minto0218/autotransfer/handoff_2026-11-08/READ_FIRST_SOURCE.md

# 軽量版の引き継ぎ

最初にREADME.md、HANDOFF.mdを読んでください。
このZIPにはCAD原本・仕様・環境構築ファイル・過去の検証記録・参照用依存ファイルが入っています。
生成済みHTML、STEP、STL、3MF、画像などの大きな成果物は省略しています（旧版比較用の依存STL等を除く）。
過去の検証記録は今回の再実行結果ではありません。
新しい環境でSETUP.mdに従い依存ライブラリを導入し、CADを再生成してください。再生成は未検証です。
省略した成果物を含め元ZIPを完全復元する場合は、同梱の分割ファイルを全て集めて結合します。
この軽量版は単独で設計の引き継ぎを始めるためのものなので、分割ファイルは必須ではありません。
