minto0218/autotransfer/handoff_2026-11-08/v0_12/docs/ばねの点検と交換.md

# V0.12 ばねの点検と交換

金属引張ばねを戻し力に使うことは一般的な機械の構成です。[Lee Springの用途説明](https://www.leespring.com/learn-about-extension-springs)も戻し力の用途を挙げています。ただし、今回のJB-14をこの運動で使った寿命試験は行っていません。

## 今の設計でできていること

- 各ヘッドの一枚側板に水平ばね3本。側板はケースへM2×2で着脱でき、ばね単体も固定ねじと糸の結びを外して交換可能。
- ねじりに合わせてばねが回転することはありません。側板は固定ケース側で、引き抜くときはヘッドと一緒に移動します。
- 自由長14mm。公称予伸び2mm、運転全域の最大伸びは把持16.19／ねじり6.19／押込み9.54mm。カタログ許容たわみ20.4mm以内という計算です。許容範囲内であることは長期寿命の保証ではありません。
- 予圧は戻し糸の有効長を調整します。固定ねじ自体に送りねじ式の予圧調整機能はありません。ばねを傷めるねじ込みや、コイルを引っ掛ける調整はしません。

## 寿命について

ばねには疲労寿命があり、負荷の大きさと振幅、材料、フック形状、腐食、傷などが影響します。特に引張ばねのフックには曲げとねじりが加わるため、コイルより先に問題が出る場合があります。[Century Springの設計説明](https://www.centuryspring.com/resources/how-to-select-an-extension-spring)。同ページにある同社製品の目安回数を、メーカーの異なるJB-14へそのまま当てはめることはできません。

張力低下を調整して補える場合はありますが、張力が正常でも亀裂などの疲労を完全に検出できるとは限りません。予圧を増やし続けて使う運用にはせず、実際の繰返し試験から交換回数と点検間隔を決めます。今の段階で具体的な保証回数は設定しません。

## 小さなヘッドのまま点検する案

ヘッドに荷重センサーを常設する代わりに、外部の点検治具に一個のフォースゲージ／ロードセルを置き、各系統を順に測る方法を推奨案とします。これは将来の追加案で、CADにはセンサーや自動点検治具をまだ実装していません。MG90Dの角度指令だけから張力は測定できません。

最初の手動点検手順：

1. 無負荷で糸の摩耗、フックの変形、コイルの接触、案内輪の回転を確認。ばねを外し、永久伸びがないか自由長も比較。
2. 同じ温度・同じ二つのばね長で、引く方向と戻す方向の力を別々に測り、新品基準と比較。ばね単体を測るとばね特性、糸を通して測ると案内摩擦を含む特性になるので、両者を混同しない。
3. 二点間の力の差からばね定数の変化、往復の差から摩擦の増大、同じ位置での力のずれから予圧・永久伸びの変化を調べる。初張力のカタログ値は未記載なので、最初の実測値を基準にする。
4. 異常のない糸長の軽微な変化なら結び直して予圧を調整。運転端で伸びの上限を越えないことを確認。ひび、フック変形、永久伸び、繰返す力の低下があれば交換。
5. 調整後に開口35〜5mm、連動ねじり±30°、押込み20mm、復帰とロック位置を確認する。

自動化では「運転回数を記録→点検治具へ移動→基準位置で低速計測→基準との差と往復差を判定→調整または交換要求」という手順にできます。サーボの原点補正は主糸側の位置ずれには使えますが、同じ開口でのばね予圧を変えるには糸長または固定点の調整が必要です。交換判断の閾値・点検間隔は実測後に設定します。センサーを付けない自動プログラムは、回数の記録と点検の案内までです。

この版ではモーターへの送信、保守プログラムの実機実行、自動張力測定はしていません。
