minto0218/autotransfer/handoff_2026-11-08/SPEC.md

# 現行仕様と今後の設計条件

単位mm・角度deg。2026-11-08。参考PDFの図は設計資料であり、後のユーザー要求で置き換えた条件より優先しない。

## 全体装置の要求

- 新旧2バイアルの栓を把持→ねじり→斜め引抜き→同じ側へ退避→逆順復帰→押込み→解放。
- バイアル径約23、高さ約96、栓長約30、想定最大外径30、装着時の突出約10。
- 接触する爪は底面基準Z100〜105、爪高さ約5。最大開口35、最小約5。実際にスポンジを5まで圧縮する意味ではない。
- ヘッド中心間52（V0.12）。回転部のCAD包絡半径25、ヘッド間余裕2。一周の包絡表示は360°実機駆動の意味ではない。
- 上下の同軸中空2ドラム、把持と中心軸周りのねじりを連動制御。旧仕様の爪前後逆移動ねじりは現在方式ではない。
- 押し足は全体の初期位置Z127→107、20mmストロークと棒回転120°。初期要求の最大30mm以内。
- 上側固定フレームへサーボ集約。全体保存版は7サーボ案（把持2、ねじり共通1、引抜き2、押込み2）。元の5個に固定しない。
- 2関節を共通軸と両側支持で構成。柱を退避側支点へ近づけ、両バイアルは同じ側へ抜く。
- ヘッドはバイアルごとに構造的独立、ねじで連結可能。バイアル供給側の外半周ホルダーを撤去し、内側に受けを置く。
- 機械式ストッパー・固定ピンで電源OFF時の基準姿勢を固定。サーボ保持だけに頼らない。
- 本番は金属。現試作はPLAで機構・組立確認。耐久最適化より、組み上がり・可動性・小型化を重視。

## 卓上B3で実装している範囲

独立ヘッド1個、支持台、手引きつまみG/T/P、ばね戻し。バイアル、全体アーム、サーボ、Pico、長い外部ボーデンは使わない。

- 開口35→5、爪高さ5、中空2ドラム。
- ねじり0〜＋30°、両端ストッパー。Tばねは0°でも約2mm伸ばし、0°で自由長14→設置長16。
- 固定ばね側板1枚に水平引張ばね3本。自由案内輪3個、共通軸M1.6×16。
- G/T連動が必要。＋30°でT糸約6.81mm引き、開口維持のG糸を約5.37mm戻す。全主糸を解放するだけの全軸原点復帰ではない。
- 押込み20＋回転120。カムは左右分割、棒の上ドラムは別体。二面幅で棒へ回転を伝え、軸方向に滑らせる。
- ケース／カムの位置合わせキー、爪の上下・背面案内、ねじ止めレール端止め、押し棒上端固定ピン。
- 糸端ビーズはドラム内固定用。ヘッド交換用ケーブルコネクタではない。

## 未採用／未設計の別案

- 無操作時「爪閉約5・ねじり0・押し棒上」。内蔵回転ばねによる常時閉じ、引きで開く方式。
- ばねをなくす拮抗2本駆動。
- 3系統着脱ケーブル接続板、張力調整、モーター側クラッチによる停電復帰。
- 自動の原点・栓検出・張力測定、メンテナンスプログラム。
- ナイロック加工ねじの採用、金属製部品の板厚・軸受選定。

これらは会話上の候補で、既存CAD・印刷部品へ反映済みとしない。

## 合格判定を今後決める項目

必要把持力／ねじりトルク／引抜き力／押込み力、許容スポンジ変形、許容位置ずれ、目標サイクル時間、連続稼働回数、ばね・糸の交換間隔。数値が未指定のため推測で合格扱いしない。
