minto0218/autotransfer/handoff_2026-11-08/HANDOFF.md

# 引き継ぎ：ここから再開する

## 最初に理解すること

目的はショウジョウバエ飼育バイアルの栓を、新旧2本同時に把持・ねじり・引き抜き・退避・復帰・押込みする自動TF装置。モーターは上側固定フレームへ集約し、ヘッドには置かない。

**現在の製作対象は `bench_manual_v3`（B3）の独立ヘッド1個の卓上手動治具。全体装置の最新保存版は `v0_12`。二つを混同しない。** B3を全体へ統合済みとは扱わない。

ユーザーは部品を「全部買った」と申告済み。ただし全商品の型番・実測寸法・到着状況は未確定。印刷成功・組立成功・動作成功を報告した記録はない。未実施と未報告を混同せず、現物の状況を確認してから先へ進む。

## 保存済みの現物確認用データ

- B3：STL34種類47個（比較用フォロワピンを含む）、ねじ25本・ナット5個、JB-14ばね3本。
- 3MFの00＝嵌合確認、01＝ヘッド一式、02＝支持台。完成に使うのは01＋02、00は試し刷り。必要個数は配置済み。
- 3MFは形状・配置・方向のみ。Bambu Studioのプリンター／支持設定やG-codeは含まない。
- A1、普通のPLA。01は0.2mmノズル・積層0.06〜0.08mm推奨、02は0.4mm・0.12〜0.16mm可。
- 02は土台を下にした配置。上部取付横板の張出し下面にサポートが必要。「ビルドプレート上のみ」を出発点に、層プレビューで確認。ねじ穴に支持を詰めない。
- cable_stop_buttonは外径2.1、厚さ0.6、穴径0.8mm、3個。小さいのは意図どおりだが印刷成功未確認。
- フォロワは金属Ø1×5.8mmを推奨。軸・ねじの形状は参考で、印刷穴を仕上げる。金属ねじを購入して使用。

## 最近の会話の合意と未実装案

1. 当面は「主糸1本＋引張ばね戻し」。拮抗2本駆動は候補であり未採用。1ヘッド3主糸、拮抗化ならモーターまで6系統になる。
2. B3は糸を全部放すだけで全軸が原点へ戻る機構ではない。G/Tの連動が必要。
3. ヘッド交換には長いケーブルとヘッド内糸を分離できる端末を検討。タイコ／溝付き受け、外筒端面固定、張力調整が候補。3系統を一枚の蓋で保持する案は独自の未設計案。現在のB3に着脱接続部はない。
4. 最後に相談した別案：無操作時に開口約5mm・ねじり0°・押し棒上端へ戻る「ばね閉じ」構造。把持／ねじり／押込みドラムの内部にねじりばねを置く案。**説明しただけでCAD未変更・性能未検証。** 初期仕様「ばねを主たる把持力保持にしない」とは異なるため、採用の最終合意と条件整理が必要。
5. サーボが停止しても保持していれば戻らない。「糸を送り出す」「電源OFF」「クラッチで解放」を別に扱う。電源OFF自動復帰は未設計。
6. 緩み止めは本番でナイロック加工ねじ等を候補。横力は位置決め部で受ける設計を優先。HARDLOCKナットはM5以上の標準品が中心で今回の小ねじには非採用。金属用嫌気性ロック剤をPLAへ安易に使わない。

## 購入に関する引き継ぎ

- 個人購入を前提。大手優先、特にヨドバシを好む。同じ店なら注文・送料をまとめたい。
- モノタロウの小頭ねじで事業者限定制限が判明、AXELも個人注文不可。購入ページに掲載があるだけで個人購入可と断定しない。
- B3_購入リンク.mdは個人向けへ更新した記録。販売価格・在庫・納期は古くなるため再確認。
- S05ばね掛けM1.4×8は頭径2.4以上。楽天ウィルコの0番3種（径2.5・高さ0.8）を代替案内。組立用S04の頭径2.0と取り違えない。
- Amazon Zmbroll M2セット B0DMF4XHCZ：M2×8/16とナットの同梱は確認。ねじ頭径≤3.6、ナット対辺≤4.0／厚さ≤1.6の実寸未確認で、適合確定にしていない。購入したか不明。
- JB-14のビルディ掲載は納期未定・受注後メーカー発注・キャンセル不可。実際の出荷日不明。以前の「1〜2週間期待、製造待ち1〜3か月」は一般的推測でありメーカー回答ではない。納期の確定値として使わない。

## 検証の扱い

保存レポートには過去のCAD上の検査結果がある。B3保存結果：代表9姿勢、組立途中1499組、ねじり37姿勢、押込み41位置等。これは連続掃引・実物の摩擦・寿命・トルク・スポンジ適合の合格ではない。今回クラウドへ移して再検証したわけでもない。

現在不足するもの：実物の嵌合、ばね力と摩擦、G/T連動時の把持力、押込み反力の受け、ケーブル全行程の変形・張力、サーボ適合、TF180°回転の実動作、原点／異常検出、実機制御。

## 再開手順

1. README→SPEC→B3 HTML・組立手順を見る。
2. `python tools/project.py verify` でコピー整合性を確認。
3. SETUP.mdに従ってCadQuery環境を作り、smokeを実行。
4. ユーザーの実際の印刷・到着・組立状況を聞く。測定があれば保存データに優先して反映。
5. 変更前にB3/B4など版を分ける。B3原本とV0.12を上書きして未実装案を既成事実化しない。
6. 寸法変更→部品→組立→動作→印刷方向・個数→BOM→HTMLを整合させる。

## 次のAIに貼る文

このフォルダーは自動TF装置の引き継ぎ一式です。最初にHANDOFF.mdとSPEC.mdを読んでください。現行の印刷対象はbench_manual_v3のB3、全体保存版はv0_12です。最近のばね閉じ・内蔵ねじりばね・ケーブル着脱案は未実装です。保存済み検査を実機検証と混同せず、現在の印刷・組立状況から継続してください。環境はSETUP.mdとtools/project.pyを使ってください。
