minto0218/autotransfer/handoff_2026-11-08/v0_12/docs/配線と購入部品.md

# V0.12 ワイヤの経路と購入部品

## 試作用線材

今回は**PE編み糸約Ø0.3＋PTFE外径1.6／内径0.8**を試作基準へ変更した。PTFE外径1.59／内径0.8の実在例は[フロン工業F-8008-003](https://www.flon-ind.com/catalog/f-8008/)。これは摩擦を減らす試作用チューブで、補強入りボーデンと同等の圧縮剛性を保証しない。曲がりによるロスが大きければ補強アウターへ替える。チューブ端を受ける肩と交換フェルールをCADへ追加した。

細いステンレス7×7も比較候補だが、この版の表示線径は0.3。釣り糸の号数だけで径を決めず、通路へ実際に通して確認する。

## 主糸3本の通し方

ヘッド局所座標はバイアル中心がX0/Y0、初期ヘッド基準がZ116。取出口はG＝(+10.25,−18)、T＝(−13,−18)、P＝(−7.3,−15)。すべて上向き。

```text
上部巻取り輪
 ↓ インナー（引張り）
上部固定ソケット＋アダプタ ← アウター上端の反力を受ける
 ↓ 外部サービスループ：ヘッド用曲線長360、肘用240
ヘッド固定ケースのフェルール ← アウター下端の反力を受ける
 ↓ 裸線の縦穴
蓋付き90°案内＋短いPTFEライナー
 → ドラム接線 → 巻取り溝 → 内部エンドビーズ＋止め結び
```

主案内は固定の滑り案内。ベアリング式の小プーリーを増やしてはいない。蓋を外して糸とライナーを置けるため、閉じた細い曲がり穴へ無理に通す必要がない。摺動摩擦は現物試験で確認する。

局所配線色はG把持＝黄、Tねじり＝青、P押込み＝桃、戻し＝緑。HTMLの「ヘッドの配線・案内の蓋を外して見る」で経路を見る。「ドラム内のワイヤ固定」は内部座を見る。座標一覧は`output/ワイヤ経路.csv`、中心線原本は`validation/wire_centerlines.json`。

外部曲線長は旧側3本・新把持・新押込みが各360、新ねじりは各姿勢とも400、肘は各240mm。新ねじりは退避姿勢でケースを避けるため40mm延長した。これらはチューブ切断長そのものではない。ヘッド側立上り5.3と端末挿入各約3を加えると、試作用の概算は通常のヘッド用約371.3mm、新ねじり用約411.3mm。現物フェルールと調整分を含め、長めに仮組みしてから端面を揃える。インナーには巻付き・結び・調整代を追加する。先に短く切り過ぎない。

## 局所戻し糸とばね

市販の**東京発条JB-14**を各ヘッド3個、計6個使う。外径2.5、自由長14、線径0.23、k0.05N/mm、許容たわみ20.4、最大荷重1.13N。[TRUSCO掲載のメーカー規格表](https://trusco.meclib.jp/library/books/orangebook2025_2/book/pdf/1425.pdf)。表の40.5は巻数、0.095は質量で、初張力ではない。

ばねをドラム間へ直接入れる代わりに、交換しやすい側面カセットへ置く。各ドラムの小さな別溝→短い戻し糸→R4自由回転案内輪→水平ばねの可動フック、固定フック→横ねじ→共通側板→ケースという力の経路。案内輪は高さの異なる3個を一本のM1.6共通軸へ通す。ばねは局所X18、Y方向に伸縮し、高さはG14.65／T21.6／P25.1。固定フックはY18。ケース側なのでねじり時には回らず、引き抜きではヘッドと一緒に移動する。主駆動のボーデン本数は増やさず、ユニット内だけ戻し糸が3本増える。

- 把持戻し溝R4、下ドラム絶対角−173.24〜+30°を対象。ばねの初期伸び2に角度分を加え、最大伸び約16.19mm。
- ねじり戻し溝R4、−30〜+30°。最大伸び約6.19mm。
- 押込み戻し溝R3.6、0〜120°。最大伸び約9.54mm。

いずれもカタログたわみ20.4以内。必要な摩擦を越えて戻れるか、糸の滑り、巻きの乱れ、予圧量は現物確認が必要。糸長を調整し、強く引き過ぎてばねを最大伸びまで使わない。水平化でばねの縦柱をなくし、最高部は押し棒上端の局所Z50、全高約66mmへ戻した（V0.11の74mmから8mm減）。主要ドラムの外径は維持。カセットは外せるので、後の金属版で内部ねじりばねへ置換する比較ができる。

この版の把持戻しばねは固定ケースを基準に下ドラムを戻す。上ドラムに対する開口はサーボ連動とラック端のストッパーで保つ。挟んだ状態は主糸を引いて保持する。

## ねじとピニオン

小頭ねじを前提とする。[日東精工の頭部寸法資料](https://www.nittoseiko.co.jp/nitto-blog/2017/08/25/6)には0番1種M1.4の頭径2.0mmがある。ばね固定フックの抜け止めだけは大頭を使い、頭径2.4mm以上にする。通常の大頭ねじへ置換するとカム／ラックに当たり得る。印刷ピニオンは小頭が座ぐりに収まるようにした。通し穴は仕上げでØ1.5へ、ねじ込み下穴はM1.4でタップする。

下ドラムとピニオンを別部品にしたが、**市販ピニオンを無加工で装着できると確定したわけではない**。試作ピニオンはm0.5／24歯／幅3、六角穴、留め穴2個。市販化では薄型の歯車を選び、穴・厚み・留め穴を追加加工するか、歯部を専用加工する。今回の別体化は外径を増やしていない。

## 本数

主インナー10走、外部アウター8走（M4だけ通常糸2本）、局所戻し糸6走。主糸の把持M1/M2は各独立、M3は2ヘッド共通、M4/M5は共通2関節、M6/M7は独立押込み。制御関係は変更していない。

全長配線は5静止姿勢の候補を検査する。同一チューブが途中で滑らかに形を変えること、ヒステリシス・圧縮・実効ストロークは未実測。局所戻し糸もばねも、表示しただけで耐久／実機作動を認定するものではない。

## 水平ばねカセットの組立

3個の案内輪を、共通側板の前後に開いた棚の隙間へ横から入れ、最後にM1.6×16の共通軸を下から通す。上面M1.6ナットで留める。輪と上下棚は片側0.2mmの隙間があり、ナットで輪自体を締め付けない。糸を掛ける前に3輪が別々に軽く回ることを確認。実ねじの頭径3.2以下、頭高1.3以下、ナット対辺3.2・厚1.3以下を選ぶ。輪の穴はØ2.1、実軸のねじ外径1.6との差を確保しているが、ねじ部での摩擦は実物試験が必要。製品版では平滑軸へ置換できる。

案内輪外径9.2、戻し糸中心半径4。主糸のR8固定PTFE案内とは別の部品。外部ケーブルを横へ出す変更ではなく、ヘッド内の短い戻し糸だけを横へ曲げる。各ばねは横向きの固定ねじの頭と共通板の間に掛け、糸長で予圧を合わせる。

寿命・校正方法は[ばねの点検と交換](ばねの点検と交換.md)。自動張力計測のセンサーや制御プログラムはこの版には未搭載。
