minto0218/autotransfer/handoff_2026-11-08/bench_manual_v2/output/print/spring_cassette.stl

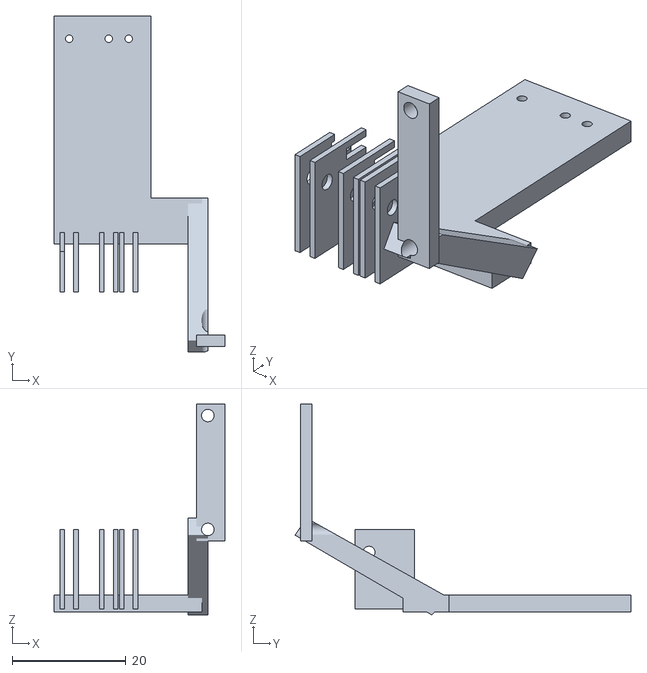
[picture p1: CAD file, 2026-11-07, an earlier design]
handoff_2026-11-08/bench_manual_v2/output/print/spring_cassette.stl
30.0 x 59.0 x 37.0
