minto0218/autotransfer/handoff_2026-11-08/bench_manual_v2/output/print/tube_reducer_25.stl

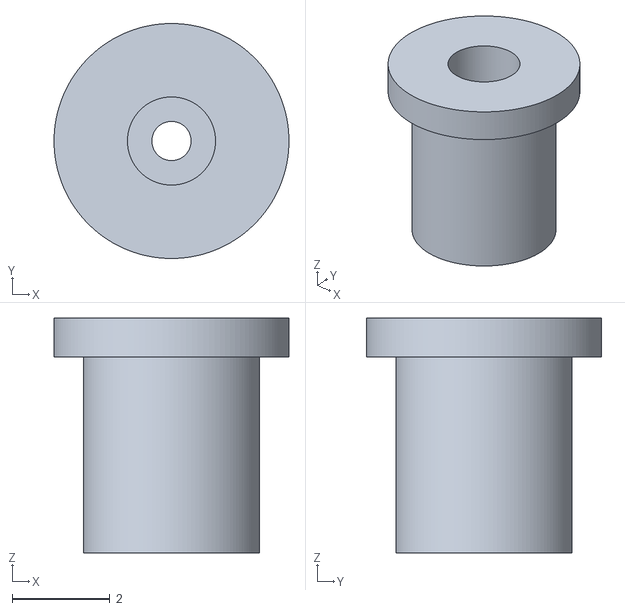
[picture p2: CAD file, 2026-11-07, an earlier design]
handoff_2026-11-08/bench_manual_v2/output/print/tube_reducer_25.stl
4.80 x 4.80 x 4.80
