minto0218/autotransfer/handoff_2026-11-08/bench_manual_v2/output/print/press_home_lock_pin.stl

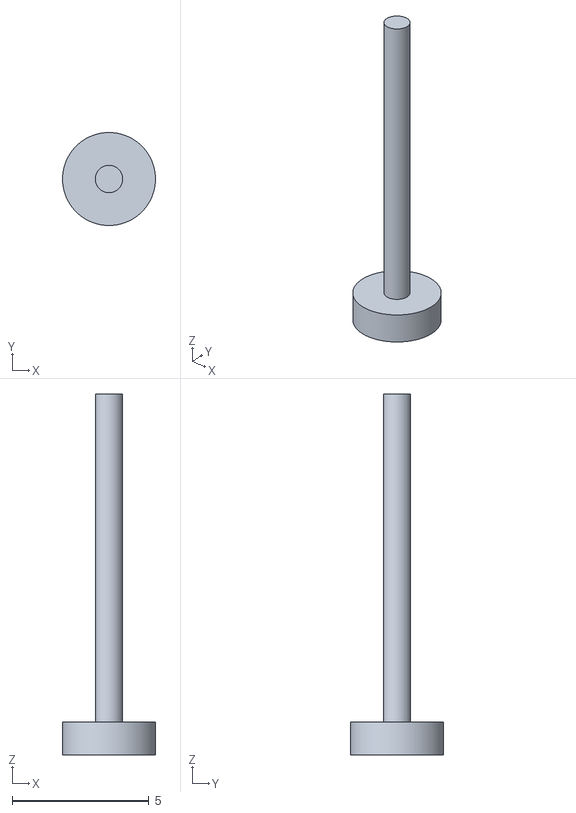
[picture p3: CAD file, 2026-11-07, an earlier design]
handoff_2026-11-08/bench_manual_v2/output/print/press_home_lock_pin.stl
3.40 x 3.40 x 13.2
