minto0218/autotransfer/handoff_2026-11-08/bench_manual_v2/output/print/return_idler.stl

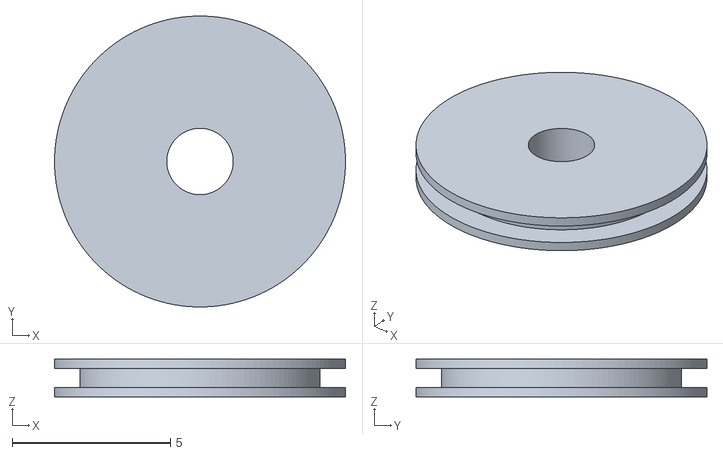
[picture p4: CAD file, 2026-11-07, an earlier design]
handoff_2026-11-08/bench_manual_v2/output/print/return_idler.stl
9.20 x 9.20 x 1.20
