minto0218/autotransfer/handoff_2026-11-08/bench_manual_v2/output/print/twist_lock_pin.stl

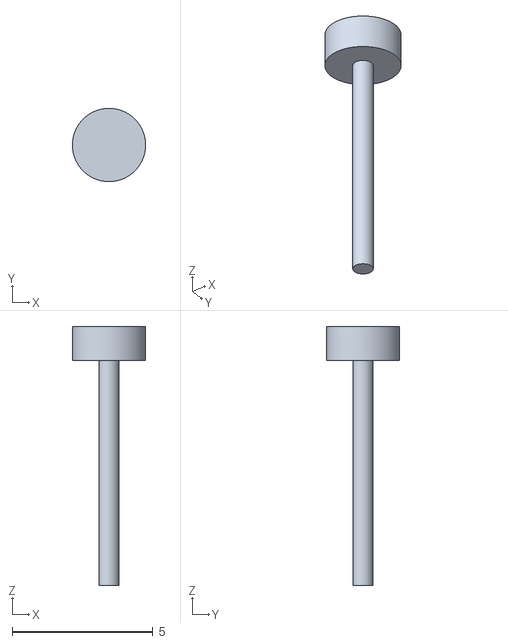
[picture p5: CAD file, 2026-11-07, an earlier design]
handoff_2026-11-08/bench_manual_v2/output/print/twist_lock_pin.stl
2.60 x 2.60 x 9.20
