minto0218/autotransfer/handoff_2026-11-08/bench_manual_v2/output/print/fit_coupon.stl

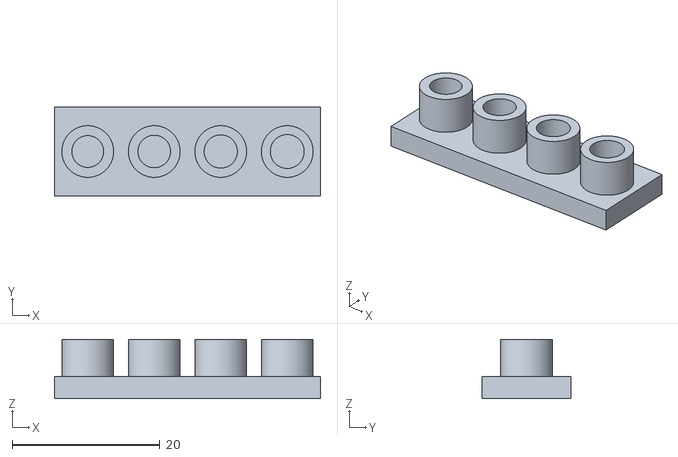
[picture p6: CAD file, 2026-11-07, an earlier design]
handoff_2026-11-08/bench_manual_v2/output/print/fit_coupon.stl
36.0 x 12.0 x 8.00
