minto0218/autotransfer/handoff_2026-11-08/bench_manual_v2/output/print/push_sliding_drive.stl

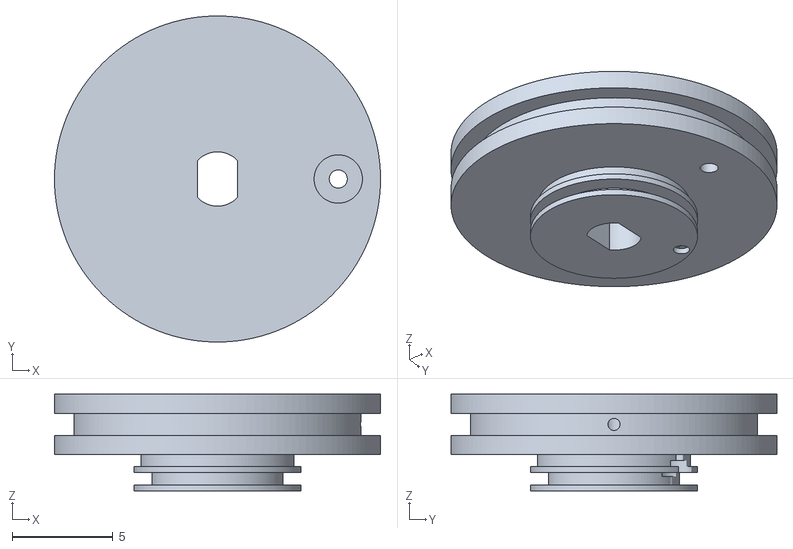
[picture p7: CAD file, 2026-11-07, an earlier design]
handoff_2026-11-08/bench_manual_v2/output/print/push_sliding_drive.stl
16.2 x 16.2 x 4.80
