minto0218/autotransfer/handoff_2026-11-08/bench_manual_v2/output/print/twist_return_spool_R.stl

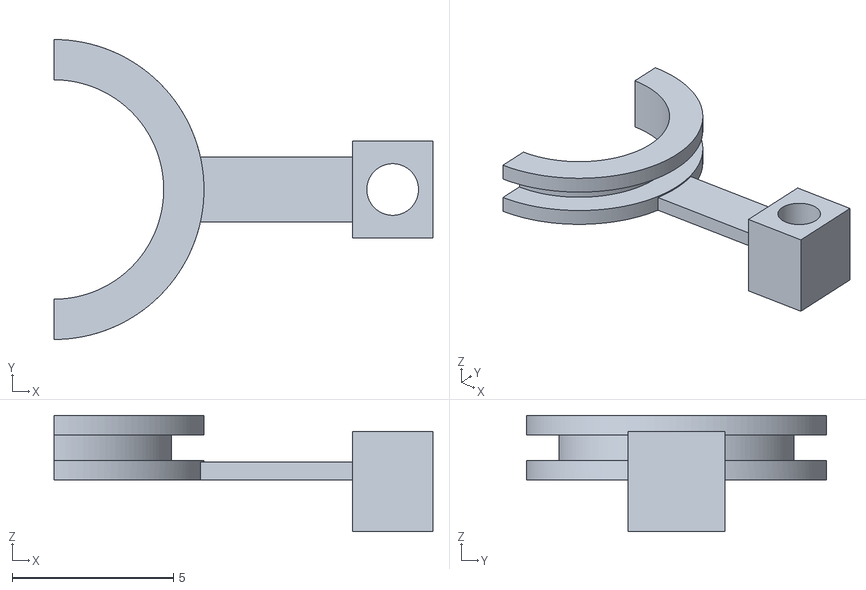
[picture p8: CAD file, 2026-11-07, an earlier design]
handoff_2026-11-08/bench_manual_v2/output/print/twist_return_spool_R.stl
11.8 x 9.30 x 3.60
