minto0218/autotransfer/handoff_2026-11-08/bench_manual_v2/output/print/fairlead_cover_P.stl

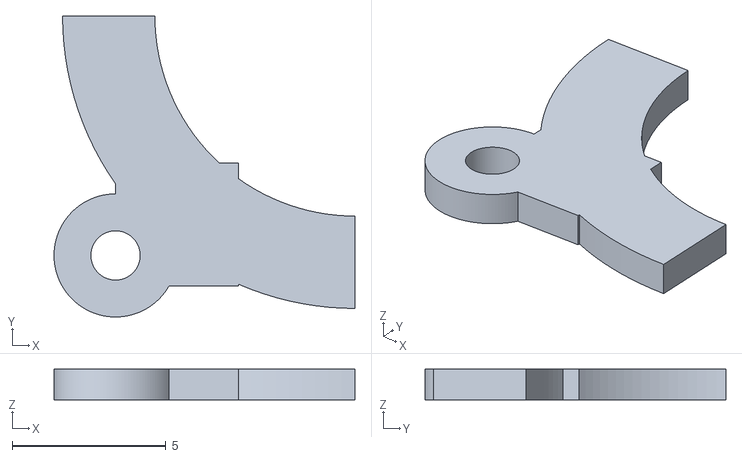
[picture p9: CAD file, 2026-11-07, an earlier design]
handoff_2026-11-08/bench_manual_v2/output/print/fairlead_cover_P.stl
9.78 x 9.78 x 1.00
