minto0218/autotransfer/handoff_2026-11-08/bench_manual_v2/output/print/bench_head_stand.stl

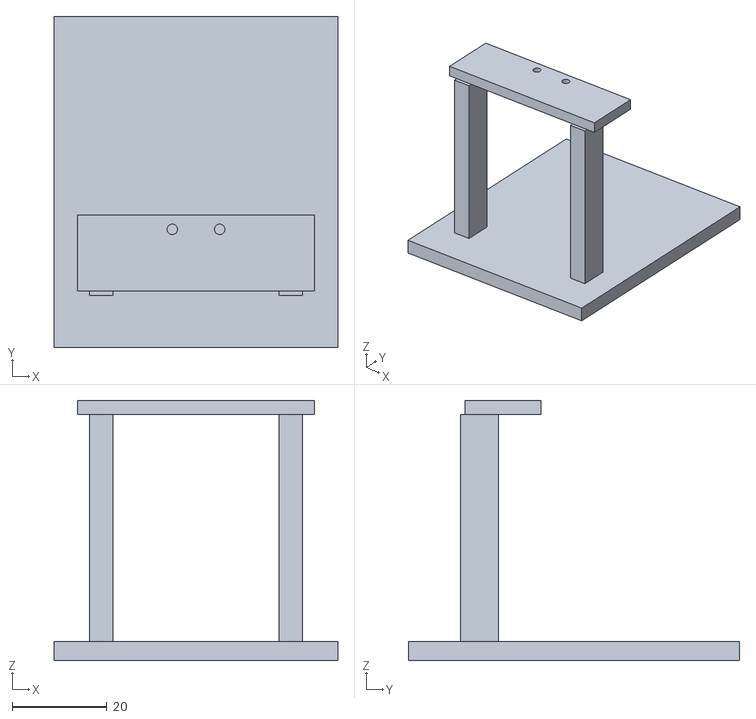
[picture p10: CAD file, 2026-11-07, an earlier design]
handoff_2026-11-08/bench_manual_v2/output/print/bench_head_stand.stl
60.0 x 70.0 x 55.0
