minto0218/autotransfer/handoff_2026-11-08/bench_manual_v2/output/print/opening_gauge_5.stl

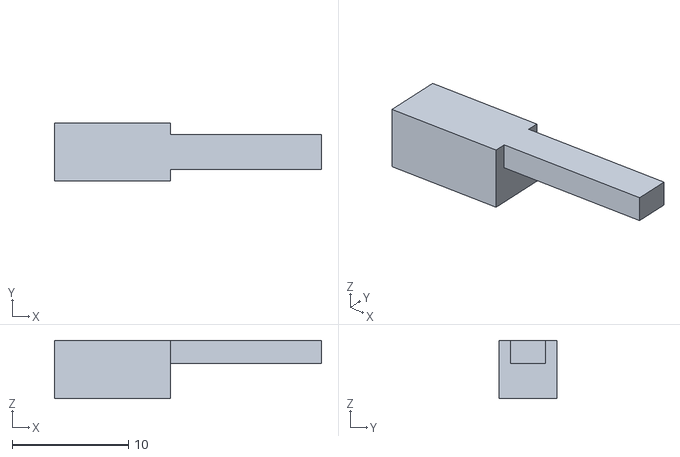
[picture p11: CAD file, 2026-11-07, an earlier design]
handoff_2026-11-08/bench_manual_v2/output/print/opening_gauge_5.stl
23.0 x 5.00 x 5.00
