minto0218/autotransfer/handoff_2026-11-08/bench_manual_v2/output/print/push_cam_right.stl

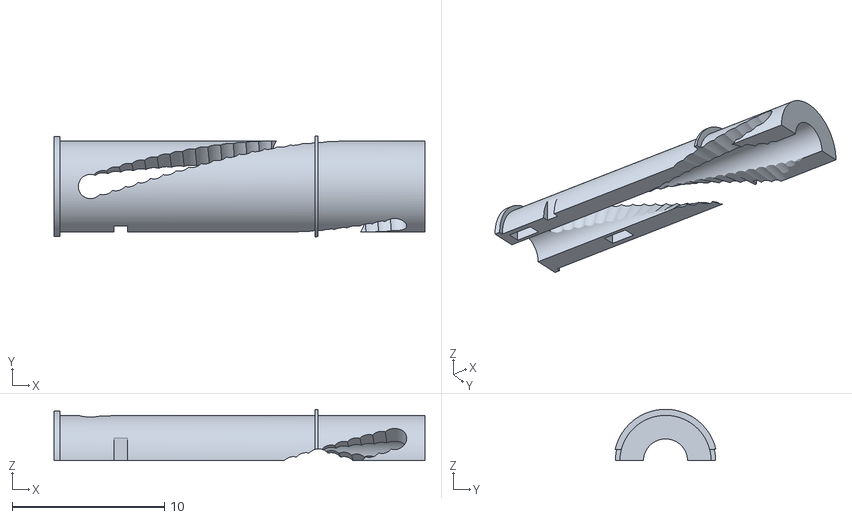
[picture p12: CAD file, 2026-11-07, an earlier design]
handoff_2026-11-08/bench_manual_v2/output/print/push_cam_right.stl
24.4 x 6.62 x 3.38
