minto0218/autotransfer/handoff_2026-11-08/bench_manual_v2/output/print/pusher_follower_pin.stl

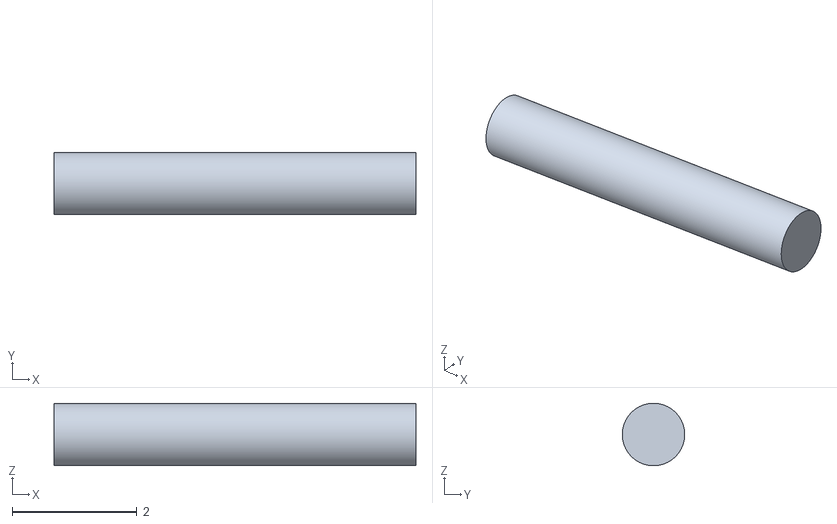
[picture p13: CAD file, 2026-11-07, an earlier design]
handoff_2026-11-08/bench_manual_v2/output/print/pusher_follower_pin.stl
5.80 x 1 x 1.00
