minto0218/autotransfer/handoff_2026-11-08/bench_manual_v2/output/print/grip_pinion_insert.stl

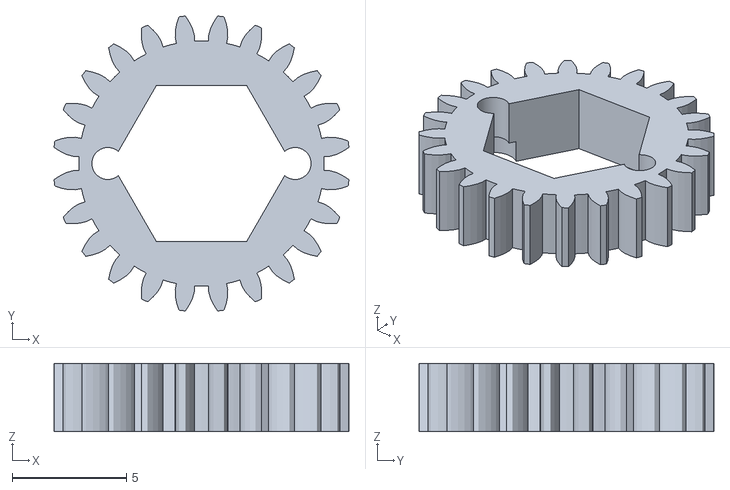
[picture p14: CAD file, 2026-11-07, an earlier design]
handoff_2026-11-08/bench_manual_v2/output/print/grip_pinion_insert.stl
12.9 x 12.9 x 3.00
