minto0218/autotransfer/handoff_2026-11-08/bench_manual_v2/output/print/twist_guide_cage.stl

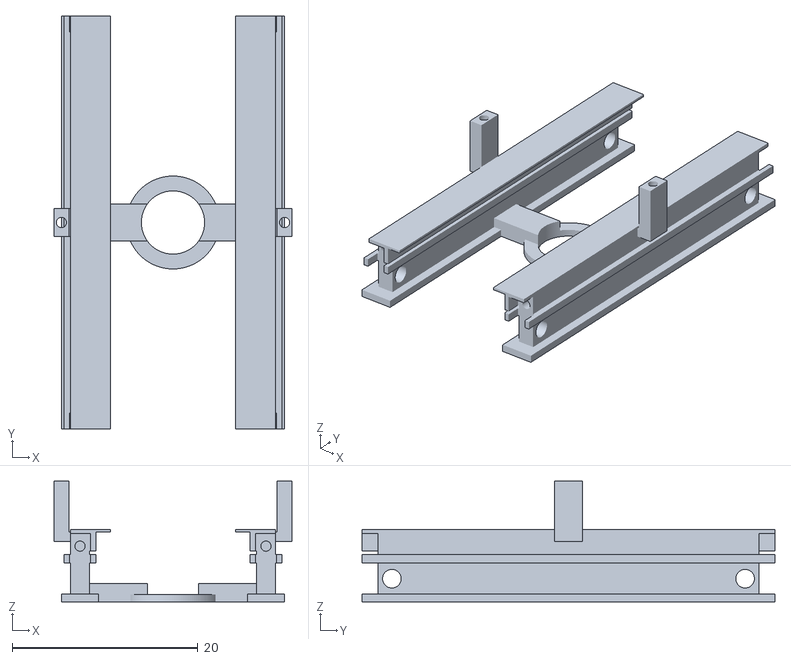
[picture p15: CAD file, 2026-11-07, an earlier design]
handoff_2026-11-08/bench_manual_v2/output/print/twist_guide_cage.stl
25.6 x 44.4 x 13.0
