minto0218/autotransfer/handoff_2026-11-08/bench_manual_v2/output/print/module_case_R.stl

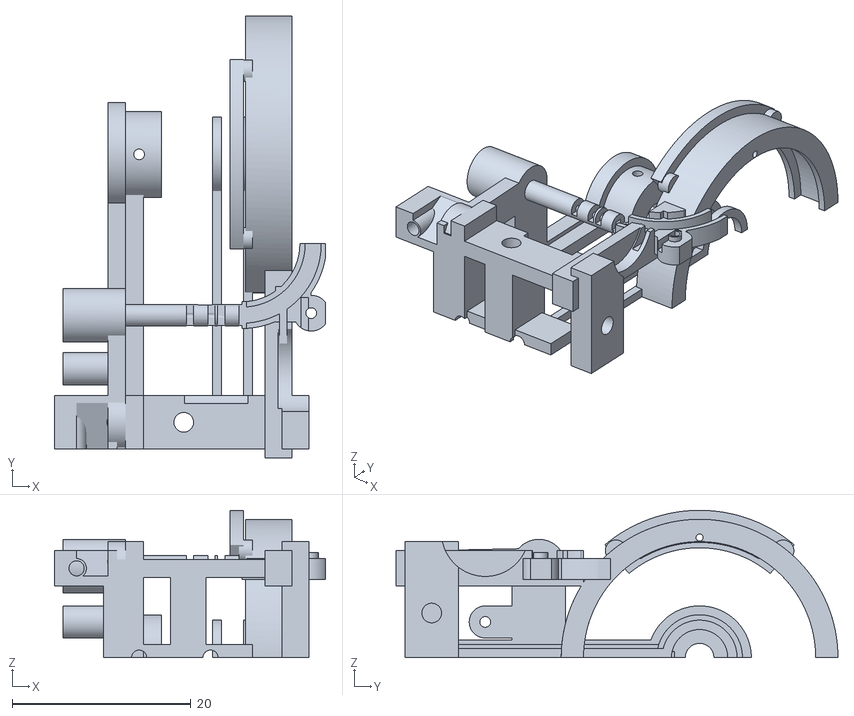
[picture p16: CAD file, 2026-11-07, an earlier design]
handoff_2026-11-08/bench_manual_v2/output/print/module_case_R.stl
30.4 x 49.5 x 16.5
