minto0218/autotransfer/handoff_2026-11-08/bench_manual_v2/output/print/case_alignment_key.stl

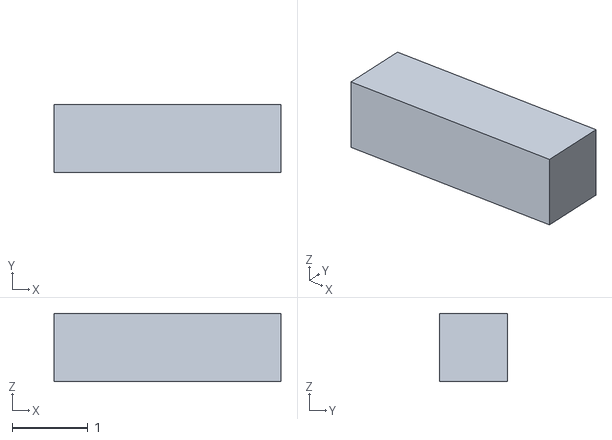
[picture p17: CAD file, 2026-11-07, an earlier design]
handoff_2026-11-08/bench_manual_v2/output/print/case_alignment_key.stl
3.00 x 0.9 x 0.9
