minto0218/autotransfer/(list of files, cad)

Other CAD files:
handoff_2026-11-08/bench_manual_v2/output/print/twist_return_spool_L.stl
handoff_2026-11-08/bench_manual_v2/output/print/cable_stop_button.stl
handoff_2026-11-08/bench_manual_v2/output/print/fairlead_cover_G.stl
handoff_2026-11-08/bench_manual_v2/output/print/fairlead_cover_T.stl
handoff_2026-11-08/bench_manual_v2/output/print/fit_coupon_pin.stl
handoff_2026-11-08/bench_manual_v2/output/print/grip_drum_pinion.stl
handoff_2026-11-08/bench_manual_v2/output/print/jaw_guide_endcap.stl
handoff_2026-11-08/bench_manual_v2/output/print/jaw_lock_pin.stl
handoff_2026-11-08/bench_manual_v2/output/print/manual_pull_tab.stl
handoff_2026-11-08/bench_manual_v2/output/print/module_case_L.stl
handoff_2026-11-08/bench_manual_v2/output/print/parallel_jaw_rack.stl
handoff_2026-11-08/bench_manual_v2/output/print/push_cam_alignment_key.stl
handoff_2026-11-08/bench_manual_v2/output/print/push_cam_left.stl
handoff_2026-11-08/bench_manual_v2/output/print/push_rotating_plunger.stl
handoff_2026-11-08/bench_manual_v2/output/print/rear_cable_retainer.stl
handoff_2026-11-08/bench_manual_v2/output/print/twist_motion_follower.stl
handoff_2026-11-08/bench_manual_v2/output/print/twist_upper_drum.stl
