minto0218/autotransfer/handoff_2026-11-08/bench_manual_v3/README.md

# 卓上手動治具 B3｜0°戻り端・片方向ねじり・曲線ブラケット

[軽量3D HTML](output/卓上手動治具.html) ／ [引き継ぎ一式の説明](../README.md) ／ [組立手順](docs/組立と手動確認.md) ／ [購入品と印刷](docs/購入品と印刷.md) ／ [B2からの変更部品](output/B2からの変更部品.csv)

B2を保存した独立改訂版。ねじりを0〜＋30°だけへ変更し、0°を機械的な戻り端にしました。取付側からばね側へのつなぎを曲線リブへ、案内輪の台と側板を丸い輪郭へ整えています。全体装置V0.12は変更していません。

## 0°の決め方

短い動作用ピンを付けたまま、T糸を戻すとTばねがピンを0°のストッパー面へ戻します。T糸の張力を中間角度で釣り合わせて0°を作る必要はありません。＋30°側にも端面があります。印刷誤差とピン穴の遊びは残るので、初回に組立用0°ピンの穴合わせとストッパーを確認します。

Tばねは自由長14mmに対して0°で16mm、＋15°で約17.05mm、＋30°で約18.09mm。**0°でも約2mmの予伸びを残す**設定です。主T糸は端止めを引き離さない位置で、大きなたるみだけを取って結びます。T戻し糸の有効長はB2より約2.09mm長くする目安。初期の巻き残しは105°で継続し、固定座も継続しています。

G糸は開口を維持するよう連動操作します。＋30°ではTを約6.81mm引き、Gを約5.37mm戻す。復帰は逆です。全ての糸を放すだけで全機構が初期位置へ揃う保証ではありません。保管・電源OFFの位置固定には従来の固定ピンを使います。戻り力・摩擦・糸伸びは実物で確かめる対象です。

## 曲線化した部分

- 取付ねじ部は丸い端部へ、斜めの直線梁は滑らかな曲線リブへ変更。
- 一枚側板の肩と先端を丸め、案内輪の上下台は輪の外周をなぞる丸い形へ。
- 取付穴、ばね固定点、案内輪の軸位置は継続。組立後も交換可能。
- 外面をX24.5に揃え、以前の梁の0.5mm張出しを除きました。印刷時は側板外面をベッド側へ。輪の隙間と軸穴へサポートを入れません。

## 継続した機構

開口35→5mm、爪高さ5mm、中空2ドラム、押込み20mm＋棒回転120°、上下に捕捉する爪レール、着脱端止め、カムとケースの合わせキー、棒の上端固定ピンはB2と同じです。押込みドラムは二面幅で棒へ回転を伝え、棒だけが上下に滑ります。摺動の遊びは現物調整が必要です。

## 印刷・購入品

STL **34種類・47個**。比較用フォロワピン1個を含み、金属Ø1×5.8ピンへ置換する場合はその印刷1個を省略。3MFは嵌合確認片／ヘッド一式／支持台の3枚です。形状と向きの配置データで、プリンター設定や支持設定、G-codeではありません。

精密部品は0.2mmノズル・積層0.06〜0.08mmを推奨。支持台は0.4mm・0.12〜0.16mm可。まず嵌合片をヘッドと同じ条件で印刷し、歯・滑り面・細穴を確認してから1台を組みます。バイアル・Pico・サーボ・長いアウターは今回不要。

必要ねじはB2と同じ**25本、ナット5個**。JB-14×3、PE約Ø0.3を約2m、PTFE1.6/0.8を約100mm、推奨金属横ピンØ1×5.8×1を用意。詳細な頭寸法条件は[購入品CSV](output/購入部品一覧.csv)。

| サイズ | 数 | 用途 |
|---|---:|---|
| M1.4×4 小頭 | 7 | 主糸案内の蓋3個＋レール端止め4本 |
| M1.4×5 小頭 | 2 | 半割ねじり戻し輪2個 |
| M1.4×6 小頭 | 4 | ピニオン2本＋後側コーム2本 |
| M1.4×8 小頭 | 2 | 上ドラムとガイド籠 |
| M1.4×8 ばね用 | 3 | 水平ばねの固定フック3本 |
| M1.6×16 | 1 | 案内輪3個を通す。下から挿入 |
| M1.6 ナット | 1 | 共通案内軸の上端 |
| M2×8 | 4 | ばね側板2本＋支持台への固定2本 |
| M2×16 | 2 | 左右ケースの横締め |
| M2 ナット | 4 | ケース2個＋支持台2個 |

## データと検査

`cad/`に自己完結した編集用CadQuery原本、`output/step/`に組立・押込み20mm・分解STEP、`output/print/`に印刷STLと3MF。HTMLは約0.97MBで10姿勢、曲線ブラケット表示と押込み断面を確認できます。ばね・糸はHTML中心線で、STEPに巻線は含めません。ねじ山は参考形状で、印刷穴の仕上げとタップが必要です。

剛体9姿勢・組立途中1499組で重なり検出0。ねじりは中間角と開口端を含む37姿勢で0。0°より負側へ回そうとすると止まり、＋側へ動けること、＋30°側の止まりも検査。押込みは41位置、拘束確認23項目を通過。曲線化後も取付・ばね・輪の支持部が残り、一部品でつながることを確認。STLは閉じた単一ソリッド・A1内、STEP3有効、Chrome10姿勢でJS/WebGLエラー0。

実際の印刷・組立・摩擦・ばね力・耐久試験は未実施です。CAD上の離散検査は、実機動作や連続掃引を全面保証するものではありません。

再生成：`python cad/run_complete.py`、`python cad/documents.py`、`python cad/make_plates.py`、`python cad/export_lines.py`。表示と検査の確認後に`python cad/release.py`でZIPを作ります。
