minto0218/autotransfer/handoff_2026-11-08/bench_manual_v3/docs/B3_購入リンク.md

# B3 卓上手動治具：個人向け購入リンク・全件再確認

2026-11-05更新。旧リストは購入制限の確認不足がありました。この版を使ってください。CAD・STLは変更していません。

全14項目について、掲載先と購入制限を再調査。下記は「個人向けの販売ページ」「取寄せ・予約」「未確定」を区別しています。注文・決済はしていません。会員ログイン後の注文可否・現在の在庫まで全件を実証したものではありません。公開ページを確認できないものを購入確定とはしていません。

**ばねは納期未定の予約扱い、PTFEチューブは海外直送で約30日です。全品がすぐ揃う状態ではありません。**

|番号|個人向けの購入先・商品|必要数|購入する量／確認結果|
|---|---|---:|---|
|S01|[ヨドバシ：EA949AB-13 M1.4×4](https://www.yodobashi.com/product/100000001006824760/)|7本|5本入×2袋。同一型番の個人向け掲載|
|S02|[ヨドバシ：EA949AB-14 M1.4×5](https://www.yodobashi.com/product/100000001006824761/)|2本|5本入×1袋。同一型番の個人向け掲載。今回の本文取得はアクセス制限、掲載情報による確認|
|S03|[ヨドバシ：EA949AB-15 M1.4×6](https://www.yodobashi.com/product/100000001006824762/)|4本|5本入×1袋。同一型番。公開ページはお取り寄せ表示|
|S04|[ヨドバシ：EA949AB-16 M1.4×8](https://www.yodobashi.com/product/100000001006824763/)|2本|5本入×1袋。同一型番の個人向け掲載。今回の本文取得はアクセス制限、掲載情報による確認|
|S05|[楽天・ウィルコ：0番3種なべ小ねじ M1.4](https://item.rakuten.co.jp/neji-wilco/f-0000n-03_140/)|3本|**長さ8.0mm**を選択、10本入×1袋。型番F-1480N-03。元の0番2種からの寸法適合代替、詳細は下記|
|S06|[楽天・トミモリ：M1.6×16 0番1種なべ小ねじ](https://item.rakuten.co.jp/nejiya/400201000016016000_b/)|1本|10本入×1袋。一般向け販売ページ|
|N01|[ヨドバシ：SUNCO M1.6 DIN934六角ナット40個入](https://www.yodobashi.com/product/100000001009685355/)|1個|40個入×1袋。個人向け掲載、お取り寄せ。表示1,160円。DIN934の対辺3.2／厚さ1.3mmに対応。楽天10個入より購入数・価格は増える|
|S07|[ヨドバシ：EA949AB-42 M2×8](https://www.yodobashi.com/product/100000001006824781/)|4本|10本入×1袋。同一型番。実ページでカート・お取り寄せ、220円表示を確認|
|S08|[Yahoo・トミモリ：M2×16 ステンレスなべ小ねじ](https://store.shopping.yahoo.co.jp/nejiya/000200000020016000-b.html)|2本|10本入×1袋。一般向け販売ページにカート表示。送料に注意|
|N02|[ヨドバシ：EA949ST-2 M2ステンレス六角ナット2種](https://www.yodobashi.com/product/100000001006827222/)|4個|8個入×1袋。公称対辺4／厚さ1.6mmの標準2種。個人向け販売掲載|
|B01|[ビルディ：東京発条JB-14](https://www.bildy.jp/machine_tools/springs-model-jb-14/283724-6)|3個|**在庫なし・納期未定、予約扱い・キャンセル不可表示**。個人利用は規約で可。元の指定型番。袋入数20個は発注前にも確認|
|L01|[ヨドバシ：ゴーセン ルーツPE×4 200m・3号](https://www.yodobashi.com/product/100000001006345071/)|約2m|1巻。Joshinで指定した商品と同じ仕様。編糸の実径・摺動性は現物確認|
|L02|[楽天・uxcell japan：PTFE 内径0.8×外径1.6mm×1.5m](https://item.rakuten.co.jp/uxcelljapan/a20120400ux0117/)|約100mm|1本。実ページで464円・送料無料・個人輸入販売を確認。中国直送、到着まで約30日表示。元のフロン工業品から同公称寸法の代替。寸法公差・実際の曲げ具合は未確認|
|P01|[ヨドバシ：光SM400-10 ステンレス線Ø1×400mm](https://www.yodobashi.com/product/100000001003838286/)|5.8mm長×1本|5本入×1袋。一般向け掲載。切断・バリ取りが必要。今回の本文取得はアクセス制限|

## 全件確認で分かったこと

- モノタロウのS01と、ユーザーから追加指摘の小頭ねじは事業者向け制限あり。他のモノタロウ商品の一般公開ページでは個人購入可否を確定できないため、個人向けリストの主リンクからはすべて外した。全モノタロウ商品が個人購入不可と判断したわけではない。
- [AXEL公式ガイド](https://axel.as-1.co.jp/contents/userguide)：一般消費者の注文不可。旧チューブ購入先は不適切だった。
- [カウネットの同チューブ](https://www.kaunet.com/kaunet/goods/44695897/)：実ページで「法人限定」「現在ご注文いただけません」を確認。代替購入先として採用しない。個人向け代替は楽天uxcellの0.8×1.6mm品とする。
- [ビルディ会員規約](https://www.bildy.jp/member_policy.jsp)：個人・個人事業主・法人を会員として定義。JB-14の実ページは予約扱いなので、即納品とは案内しない。
- S05の代替[メーカー寸法表](https://wilco.jp/products/F/F-N-03.html)：M1.4、ピッチ0.3、頭径2.5、頭高さ0.8、長さ8.0の品番F-1480N-03。元の0番2種とは頭高さ・材質が異なるが、ばねフック用のB3寸法条件内。実物組立は未検証。

## 間違えやすい点

- S01〜S04は頭径2.0mmの小頭タイプ。通常のM1.4なべねじで置き換えないこと。実測頭径2.05mm以下がB3の条件。
- S05はばねのフック用で頭径2.4mm以上が必要。個人向け代替は0番3種のM1.4×8、頭径2.5／頭高さ0.8mm。B3の頭部モデルは高さ1mmで、この代替は寸法条件内。元の想定0番2種（高さ0.5mm）と同一品ではない。S04の小頭品とは別商品。
- S06の0番1種M1.6は公称頭径2.4mm・高さ0.55mmで、B3上限の径3.2／高さ1.3mm内。長さは首下16mm。
- S07はNBK SNZS-M2-8のエスコ小分け品。頭径3.0mmでB3上限3.6mm内。
- S08は通常のなべ頭（公称頭径3.5mm）。座金組込み・バインド・トラス頭は選ばない。
- N01は対辺3.2／厚さ1.3mm、N02は対辺4.0／厚さ1.6mm。
- JB-14は外径2.5、自由長14、線径0.23mmの引張ばね。寸法だけ似た別ばねはばね定数が違うため避ける。
- PE糸の「3号」は実測直径0.3mmの保証ではない。通糸して引っ掛かりがないか確認する。ナイロン・フロロリーダーとは別物。
- PTFEは内径0.8／外径1.59〜1.6mm。一般的な3Dプリンター用の外径4mmチューブは適合しない。AXELは個人注文不可、カウネット同品も法人限定。楽天uxcellの同公称寸法品へ変更。実物の穴通り・曲げ具合は現物確認が必要。
- 金属線は加工素材。完成済みØ1×5.8ピンではない。

## 寸法確認の資料

- [NBK SNZS寸法図](https://www.nbk1560.com/images/ja-JP/product/miniaturescrew/SNZS-S/SNZS-S_1.pdf)
- [NBK 0番2種M1.4寸法](https://www.nbk1560.com/products/specialscrew/nedzicom/miniaturescrew/SNZ2S/SNZ2S-M1.4/)
- [フロン工業 F-8008仕様](https://www.flon-ind.com/catalog/f-8008/)

## cable_stop_buttonについて

設計寸法は外径2.1mm、厚さ0.6mm、穴径0.8mm、3個使用。糸端の結び目を受ける印刷ビーズで、小さいのは設計どおり。0.2mmノズル推奨。0.4mmノズルでの再現は保証していません。上記購入品とは別の印刷部品です。

この治具は手動確認用なのでPico・サーボ・モーター電源は不要。工具は別途、精密ドライバー、金属線の切断・端面仕上げ工具、穴さらい等を用意してください。

### PTFEチューブ最終追記

楽天uxcell japanの実商品ページをブラウザで確認：商品番号a20120400ux0117、内径0.8×外径1.6mm×1.5m、材質PTFE、個人輸入・中国直送、カートと購入手続き表示あり。表示464円・送料無料、発送1〜3営業日、到着まで約30日。販売店に掲示された公称寸法がB3条件に一致。実測公差・最小曲げ半径は未確認。

## ヨドバシ優先への更新（2026-11-05）

S07・N01・N02・L01を追加でヨドバシへ変更。S01〜S04とP01を合わせ、14品目中9品目をヨドバシへ集約。S05（ばね掛けM1.4×8）、S06（M1.6×16）、S08（M2×16）、B01（JB-14）、L02（PTFE0.8×1.6）の適合品は、今回ヨドバシで確定できず元の個人向け販売先を維持。ヨドバシで取扱いがないと断定したわけではない。M2×15や座金組込M2×16はそのまま代替にしない。
