minto0218/autotransfer/handoff_2026-11-08/bench_manual_v3/docs/購入品と印刷.md

# 卓上手動治具 B3：購入品と印刷

この一式はバイアルなしでヘッド1個を手で動かすものです。Pico、サーボ、サーボ電源、全体アーム、長い外部アウターは使いません。G/T/Pの主糸を上向きに引き、各ドラムを動かします。ねじ山はCADで省略しているので、ねじは購入品です。

## 必要な購入品（完成1台、予備を含まない）

| 番号 | 種類 | サイズ・型式 | 数 | 寸法条件／用意する量 | 使用箇所 |
|---|---|---|---:|---|---|
| S01 | 小頭ねじ | M1.4×4 | 7 | 0番1種なべ頭、公称頭径2.0mm（実測2.05以下） | 主糸案内の蓋3個＋レール端止め4本 |
| S02 | 小頭ねじ | M1.4×5 | 2 | 0番1種なべ頭、公称頭径2.0mm（実測2.05以下） | 半割ねじり戻し輪2個 |
| S03 | 小頭ねじ | M1.4×6 | 4 | 0番1種なべ頭、公称頭径2.0mm（実測2.05以下） | ピニオン2本＋後側コーム2本 |
| S04 | 小頭ねじ | M1.4×8 | 2 | 0番1種なべ頭、公称頭径2.0mm（実測2.05以下） | 上ドラムとガイド籠 |
| S05 | ばねフック用ねじ | M1.4×8 | 3 | 頭径2.4以上。公称2.5mmの0番2種なべ頭を想定 | 水平ばねの固定フック3本 |
| S06 | 共通案内軸ねじ | M1.6×16 | 1 | 頭径3.2以下・頭高さ1.3以下。首下長16mm | 案内輪3個を通す。下から挿入 |
| N01 | ナット | M1.6 | 1 | 対辺3.2以下・厚さ1.3以下 | 共通案内軸の上端 |
| S07 | ねじ | M2×8 | 4 | なべ頭・頭径3.6以下 | ばね側板2本＋支持台への固定2本 |
| S08 | ねじ | M2×16 | 2 | なべ頭・頭径3.6以下 | 左右ケースの横締め |
| N02 | ナット | M2 | 4 | 対辺4.0以下・厚さ1.6以下 | ケース2個＋支持台2個 |
| B01 | 引張ばね | 東京発条 JB-14 | 3 | 外径2.5・自由長14・線径0.23・k0.05N/mm | 把持・ねじり・押込みの戻し |
| L01 | PE編み釣り糸 | 実測径約0.3mm | 1 | 主糸3本＋戻し3本。仮組み用に計2m程度を用意 | 仮切断の目安：主糸各250mm、戻し各150mm。結んでから余りを切る |
| L02 | PTFEチューブ | 外径1.59〜1.6／内径0.8mm | 1 | 100mm程度を用意。曲線ライナー約12.6mm×3本を現物合わせ | 主糸の90°案内内のみ。外部の長いチューブなし |
| P01 | 推奨置換用の金属丸ピン | Ø1.0×5.8mm | 1 | 印刷比較用STLも同梱。主構成では金属ピン推奨 | 押し棒の横フォロワ。棒中央だけに少量接着 |

ねじ合計25本、ナット合計5個。長さは首下長です。M1.4×8は小頭2本とばねフック用の大きめの頭3本を区別します。M1.4ナットは不要です。M2×8の4本のうち2本は印刷部品の下穴へ、2本は支持台のナットへ締結します。普通の大きな頭のM1.4を全箇所へ使うと隣の部品に当たります。

小頭寸法の参考：[日東精工 0番ねじ頭部寸法](https://www.nittoseiko.co.jp/nitto-blog/2017/08/25/6)。個別の商品や販売在庫までは指定していません。市販ねじの公差を含め、頭の実寸を確認してください。

必要工具：0番の精密ドライバー、小型ナット用工具、ピンセット、ノギス、細いドリル（Ø0.8、1.1、1.5、2.1〜2.2など）、M1.4/M2タップ、ヤスリ、少量の接着剤。小穴を手でさらい、摺動部を合わせる仕上げを含む試作です。ねじの通し穴と、ねじ込む下穴を区別します。

## 0.4mmノズルで厳しい箇所

別体ピニオンはm0.5／24歯で、CAD上の歯先幅は約0.282mmです。戻し溝には約0.25mmの半径方向の肉厚、ねじり戻しスポークには高さ0.55mm、固定／動作ピンにはØ0.7mmの部分があります。耐久性を無視しても、形状が潰れれば動作確認ができません。このため、歯車・ラック・ドラム・カム・右ケースの端止めには**0.2mmノズルを推奨**します。これは本モデルの形状からの判断で、印刷実測の合格判定ではありません。

0.4mmの最細積層はZ方向を細かくしますが、歯先などXY方向の細さをそのまま再現できる保証にはなりません。0.4で試す場合は、全てを先に印刷せず、ピニオンと爪ラック各1個だけを出し、歯が分離して滑らかに噛むことを確認してください。

- 0.2mmノズル：通常PLA、積層0.06〜0.08mmを出発点。ヘッド一式をこのノズルで統一してよい。
- 支持台：0.4mmノズル、積層0.12〜0.16mmでよい。外観の最細設定は不要。
- 嵌合確認片：ヘッドと同じノズル・材料・補正で先に印刷。隙間0.15／0.20／0.25／0.30mmを比較。
- ドラムは平面をベッドへ。半割ケース・カムは分割面をベッド側へ。ガイド籠や側板の張出しには必要な支持だけを付け、歯・糸溝・軸穴・カム溝へ支持を埋めない。
- 側板と曲線梁の外面は同じ位置に収まる。外面をベッド側にし、曲面と輪の隙間の層を確認。新しい右ケースの円弧ガイドの下も層プレビューで確認。
- Ø0.7のピンは立て印刷を想定。小さなブリムを使い、先端と穴を現物合わせ。ピンの差込みでドラムを無理に押さない。

3MFは造形方向と個数をまとめた標準モデル配置データです。Bambuのプリンター／ノズル／材料／支持設定を保存したプロジェクトやG-codeではありません。スライス、層プレビュー、実際の印刷品質は現物確認が必要です。
