minto0218/autotransfer/handoff_2026-11-08/v0_12/docs/組立手順.md

# V0.12 印刷・組立・手動試験

V0.11は保存済み。基本は中空2ドラム、上部7サーボ、同側退避、2関節両側支持、開口35→5、押込み20mm。今回は耐久設計ではなく、印刷後に組立と変位を試すための改訂です。CADでの検査と現物試験は区別します。

## まず印刷するもの

`output/print/`が配置方向を付けたSTL。`output/stl/`はCAD原点の部品で、ねじの参考形状も含むため一括で印刷しません。`output/print/印刷一覧.csv`のone_head_quantityで独立ヘッド1個分を選び、`bench_head_stand`、`bench_anchor_back/front`各1個、`upper_PTFE_adapter`3個、`manual_pull_tab`3個、`fit_coupon`と`fit_coupon_pin`各1個を追加します。

最初に嵌合片だけ印刷。左からØ4に対する半径隙間0.15／0.20／0.25／0.30。ピンが手で滑る組合せを確認します。CADの主な軸受は半径隙間0.2mm前後。プリンターで合わなければ、軸を軽く研磨／穴をさらうか、その箇所の寸法を修正して再印刷します。全穴へ一律の寸法補正をかけないでください。

PLA、積層0.12mmを出発点にします。小型m0.5歯車は0.4mmノズルで歯先が潰れないか確認し、必要なら0.2mmノズルを使います。ケース・カムは半割面、歯車は平面をベッドへ。軸と押し棒はブリムを使用。摺動面と糸通路へサポートを埋めない配置です。印刷方向は提案であり、スライサーの各層プレビューを確認してください。

## 必要な購入部品と仕上げ

- JB-14引張ばね3個／ヘッド：外径2.5、自由長14、線径0.23、ばね定数0.05N/mm、カタログたわみ20.4。初張力はカタログに記載なし。巻数40.5と混同しない。
- PE編み糸は実測径約0.3mmを基準。主駆動3本、局所戻し3本／ヘッド。保持力・滑り・摩擦は現物確認。最初は手で引いて試します。
- 外部試作用PTFE：外径約1.6／内径0.8。主案内の短いライナーも同寸法。柔らかいPTFE単体の圧縮・蛇行によるストローク損失は未実測です。損失が大きければ補強アウターへ変更する必要があります。V0.10の未選定OD2.5アウターをそのまま購入指示にしていません。
- 0番1種等の小頭M1.4（頭径2.0mm以下）：ピニオン2本、上ドラム2本、案内蓋3本、フェルールコーム2本／ヘッド。首下長の目安は順に6、8、4、6mm。`retainer_M12_screw`／`rotor_M12_screw`という旧部品名でも、試作ではM1.4小頭を使用します。
- M2×16＋M2ナット：ケース横締め2組。M2×8：カセット2本。M2×8＋ナット：支持台への2組。ねじり戻し輪の半割2個を小頭M1.4×5で各1本留める。ばね固定フック用だけは頭径2.4mm以上のM1.4×8とし、フックが頭を抜けないようにする。
- フォロワはØ1×6.3の金属ピン推奨。印刷確認用形状も保存。Ø1.1程度の穴へ挿し、抜けないよう**棒とピンの中央接触部だけ**へ少量接着。カム溝には接着しない。ピンが棒へ固定されても、半割カムと半割ケースを開けば取り出せます。
- 小穴用ドリル、ヤスリ、M1.4／M2／M3のタップ等。ねじ山はSTLに彫っていません。印刷下穴をさらってタップで作ります。ねじのCAD円柱はねじ谷径相当の簡略形状です。

M1.4の**通し穴はØ1.5以上**にさらします。ピニオン／案内蓋の通し穴と、ねじ込む下穴を取り違えないでください。小頭径を条件にしており、通常の大きな頭のねじへ無条件に置換しません。必要なら頭の座ぐりだけ追加仕上げします。実サーボのホーン穴・スプライン・取付寸法は現物で合わせます。

## 独立ヘッドを組む順序

1. **ケースはまだ閉じない。** 別体ピニオン`grip_pinion_insert`を下ドラムの六角座へ差す。下から小頭M1.4×6を2本留める。頭は下面の座ぐり内へ。ここはガイド籠へ入れた後だと工具を通せないので先に締める。把持の主糸と戻し糸も、この時点で内部座へ通して止め結びを作る。
2. 左右の爪ラックをCガイド端から入れる。5mmパッドはラックと一体化したため、単なる突合せ接触の別部品はなくした。ラックが外へ抜けない位置を確認。
3. 下ドラム＋ピニオンの組をガイド籠へ上から入れ、左右ラックを同じ位置で噛ませる。初期開口35mmに合わせる。ねじり主糸を上ドラムの内部座へ先に固定してから、上中空ドラムを被せ、ガイド籠へ小頭M1.4×8を2本留める。
4. 押し棒の横ピンを取り付け、中央だけ接着して棒に固定する。左右の半割カムをピンへ合わせて閉じる。上の`push_sliding_drive`は**棒と別部品**で、棒の上端から差し込む。押込み主糸と押込み戻し糸は、この駆動ドラムが外にあるうちに固定する。
5. ドラム・ガイド籠・半割カム・押し棒・上の駆動ドラムを、左右に開いたケースで挟む。カムの後側キー溝をケースのキーへ合わせる。下の押し足は一体のままでよい。**ケースとカムが開き、上のドラムも外せるので、押し足を閉じた輪へ無理に通す組立ではない。**
6. ケース後側のM2横ボルト2本（局所Z27、34.5）とナットを締める。締め過ぎで回転部を挟まないよう、手で回して確認。カムはキーで回転と軸方向を位置決めする。止めねじは廃止した。主回転部はケースの上下の肩、押込みドラムは中央カムと上ガイドで軸方向を受ける。
7. ねじり戻し輪の戻し糸の座は、上面の約0.1mm薄膜をØ1.6で深さ0.9mmさらう。戻し糸を先に通し、止め結びを座の上面から出ない高さへ収める。半割2個を、最終位置より1.7mm上げた状態で左右から入れる。そのまま中央へ寄せて1.7mm下げ、小頭M1.4×5を各1本で上ドラムへ留める。閉じたリングを中央のカムへ横から無理に通さない。
8. 先に固定した主ワイヤを確認する。固定し忘れた場合はケースを開いてやり直す。Ø0.8の穴をさらった印刷エンドビーズへ糸を通し、ビーズを抜けない止め結びにして座へ入れる。結びとビーズの実際の抜けを手で確認。巻取り溝へ所定の方向に巻く。結び部は蓋を閉じる前に扱う。
9. 案内の蓋3個を外した状態で、曲線部分へ短いPTFEライナーを置く。曲線中心半径8、90°なので曲線長約12.6mm。端は裸線の縦穴／接線に滑らかにつながるよう現物で揃え、通路へ突き出した角を残さない。糸を通してから蓋を小頭M1.4で留める。
10. 頭部フェルールへ長いPTFEアウターを差す。端面を内部の肩へ当て、3線コームを締める。アウターごと引き抜けないか確認。
11. 共通側板をケースへ付ける前に、3個の自由回転案内輪を各高さの棚へ横から入れる。共通M1.6×16軸を下から通し、上面ナットで留める。輪が独立して回ることを確認する。輪の上下各0.2mmの隙間を保ち、輪を締め付けない。
12. 戻し糸3本を小さい専用溝へ固定して巻く。把持側は下ドラム上面、ねじり側は半割戻し輪上面、押込み側は押込み輪下面へ止め結びを置く。ねじり側は組立前に結びを座内へ収めておく。共通側板上のR4案内輪を回し、水平ばねの可動フックへ直接結ぶ。固定フックを横向きの大頭ねじ（頭径2.4以上）へ掛け、側板をケースへM2×8の2本で留める。糸長で予圧を調整する。ばねは回転ドラムへ直接巻き付けず、直線方向に伸びる。
13. ヘッドを卓上治具または共通連結台へM2×2で留める。卓上治具では後側／前側クランプを支柱へM2×25＋ナット4組で留め、3個の上部アダプタを横向きの穴へ入れる。アウターをそこで固定し、後ろへ出したインナー端へ手動つまみを付ける。開口35で戻しが効く程度から始める。爪を閉じた状態の保持は主糸の引張りで行う。

取り外しは逆順。コーム／案内蓋／カセットを先に外し、糸を緩め、ケース横ボルトを抜いて開く。押し棒の足と上ドラムで内部部品を永久に閉じ込める構造にしない。

## 単体で確かめる動き

最初に爪の開放ロック2本とねじりロック1本を抜きます。抜け止めのCクリップとは別の部品です。主糸を強く引く前に手で自由に動くことを確認します。

- 主把持糸を引いて35→5mmの範囲を確認。35→5の理論巻取りは約25.63mm。スポンジを必ず5mmまで潰す意味ではない。
- 上ドラムを30°ねじるときは、下ドラムも同じ角度だけ動かして相対角を維持する。主把持糸側の補正量は約5.37mm、ねじり糸側は約6.81mm。手動で同期の考え方を確認後、M1/M2とM3の連動制御へ移す。
- 押込み主糸の理論巻取り約15.29mmでカム120°／下降20mm。棒を戻したときに糸がたるまず、ケースやカムが動かないか確認する。
- 卓上治具は**ヘッド内部の変位確認用**。96mmバイアルの抜栓軌道や再装着を再現する高さの治具ではない。バイアルを使う全行程は全体アームへ取り付けて試す。

## 全体へ組む順序

ベース／柱のフレームを先に用意。A1の範囲に入る寸法だが、長い横梁と穴にはスライサー上で支持方法を確認する。上板は左右2枚へ分割し、上面の継ぎ板2枚とM3で接続。柱上端へM3で留める。サーボ台は上板へM2で固定。

中央ケース足の下面開放ポケットへM2ナットを入れ、根元はM2×12、肘はM2×10で固定。ホルダーのナットはフレーム底面の凹みへ入れ、M2×6の頭はホルダーの切欠きへ収める。サーボ台はM2×10＋ナット各4組。中央歯車ケースは側方の開口から大歯車→小歯車を入れ、通し六角軸を差す。丸い途中段差で六角穴を通れない問題をなくした。主アーム・垂直キャリア・受動リンクを順に通し、最後に軸端溝へCクリップを横から入れる。ヘッド主短軸・受動短軸、上部増速軸にも抜け止めを付けた。クリップの嵌合は手で確認し、必要な分だけさらう。押込みの反力ブラケットを柱へ留めて隙間を調整する。

M4通常糸2本、M5拮抗アウター2本、各ヘッドの主アウター3本を通す。上部／肘の小さいアダプタは端面の肩でアウターを受ける。動くループ全体を硬く結束せず、指定した端点の間は曲がる余裕を残す。

段階0の関節ピン2本・爪ピン4本・上ドラムピン2本を差し、まず手動で位置を確認。実サーボへの指令送出・自動解除・全TF運転は今回実行していない。

## V0.12の変更箇所

ばねは3本とも横向きで、一枚の共通側板。高さの差を利用し、ばね同士の最小外周隙間は公称1.0mm（T/P）。ばねのフックは個体で向きが違うため、無理にねじらず向きを合わせる。共通側板とばねは回転ドラムから独立し、ヘッドの固定ケースへ取り付く。

ねじり戻し輪の水平スポークは高さ0.55mmへ低くし、戻し糸が上を通る。積層0.12mm以下、薄肉部分のスライスを確認。これは運動確認用寸法で、製品の強度を認定したものではない。案内輪の段は横から組み、一本の共通軸を最後に通すので、積み重なった閉じた棚へ輪を無理に押し込まない。
