minto0218/autotransfer/handoff_2026-11-08/bench_manual_v3/cad/viewer_template.html

卓上手動治具 B3独立ヘッド1個・バイアルなし・サーボなし

中空2ドラム／開口35→5mm／ねじり0〜＋30°／押込み20mm

0°へ戻る片方向ねじり・曲線ブラケット。
G・T・Pの3本の糸を上から手で引きます。ばねは購入品3本、ねじも購入品です。

## 確認する姿勢

## 見たいところ

曲線ブラケットと案内輪台を見る押込みの仕組みを断面で見る 購入ねじ・ナット・横ピンを表示 主糸・戻し糸・ばねを表示 ケースを外して内部を見る カムを外して押し棒を見る

斜めから横から

下から上から

押込みの力の伝わり方

P糸 → ドラムが回る → 二面幅の穴が棒を回す → 横ピンが固定の螺旋溝を進む → 棒だけが下がる。

縦断面表示は右半分を残した説明用の切断です。印刷STLは切断していません。

## 糸とつまみの色

G：把持
T：ねじり
P：押込み
緑：戻し糸／灰：金属ばね

細かい部品は0.2mmノズル推奨。積層を細かくしても、0.4mmノズルの横方向の限界は残ります。印刷前に「印刷部品一覧.csv」を確認。

手動試験の順番

1. まず固定ピンで初期位置を合わせる。
2. 長い0°ピンを短い動作用ピンに替え、爪のピン2本を抜く。Tを引かず0°端止めでGを確認。
3. GとTを連動させ、0°から＋30°までだけねじる。
4. Tを戻して0°端止めへ復帰。爪を開き、棒の固定ピンを抜いてPを引く。

棒の上端は横向き固定ピンで保持。押込みの前に抜きます。つまみを放すと、ばねで戻ります。Tは0°の機械端へ戻ります。短い動作用ピンは操作中も0°復帰時も付けたままです。長い0°ピンは組立・保管用で、途中位置を釣り合わせるためには使いません。

使い方と検証範囲

ドラッグで回転、ホイールで拡大、Shift＋ドラッグで移動。台底面がZ0。表示は離散姿勢で、速度や摩擦の実測ではありません。ばね・糸は表示用中心線で、STEPには巻線を入れていません。手の形状や結び目の入り具合、実物の印刷品質は未確認。

説明・データ一覧
印刷個数・ノズル
ねじと購入部品

軽量CADを読み込み中…
