minto0218/autotransfer/handoff_2026-11-08/VERIFICATION.md

# 今回の引き継ぎ検査

```json
{
  "date": "2026-11-08",
  "python_syntax_files": 65,
  "json_parse_files": 40,
  "cad_original_files_byte_identical": 70,
  "bench_stl_types": 34,
  "bench_3mf_archive_xml_checked": 3,
  "cad_kernel_rebuild_this_session": false,
  "docker_cloud_boot_tested": false,
  "physical_test_claimed": false,
  "reason": "Fresh dependency installation blocked by DNS/network restrictions. Docker unavailable. Saved earlier CAD results retained as history."
}
```

これはパッケージ検査です。保存済みCADレポートは以前の実行結果で、今回の再実行合格ではありません。requirements.txtは完全な依存ロックではありません。
