minto0218/autotransfer/handoff_2026-11-08/history/以前の引継ぎ.md

# 最新作業：卓上手動版B3（2026-11-04）

[README](bench_manual_v3/README.md)、[組立手順](bench_manual_v3/docs/組立と手動確認.md)、[HTML](bench_manual_v3/output/卓上手動治具.html)を読む。ユーザー要望は「0°を戻り端にして＋方向だけへねじる方式へ調整して印刷用を再納品」＋「土台取付側からばね側へのつなぎを曲線に、3案内輪の四角い板も丸くかっこよく」。両方対応済み。B2と全体版V0.12は未変更。

## 確定内容

- bench_manual_v3は自己完結したCadQuery原本。運転TWは0〜＋30のみで範囲外入力を拒否。build.pyの固定ガイドは−12〜40°セクタ、穴は0〜30°。両端を接線方向の平面で切り、公称ピン中心の0°と30°が止まる。丸穴の遊び分で原点を決めない。ガイド取付の下側支柱は−38→−10°へ移し、不要な遠い柱を残さない。
- 通常運転では0°でも短い動作用ピンを付ける。長い0°ピンはlocks=Trueの組立／保管だけ。0°保持をT糸で途中釣合わせする必要なし。Gは開口を維持する連動操作が必要。3本全ての糸を放しただけで全機構が原点へ戻る保証ではない。全OFFの初期固定には従来の4本のピンを使う。
- prototype.RETURNのTはreference=0、reserve=105（旧−30/75）。これにより実ドラムの糸固定穴の角度は維持し、初期巻き残しも105°のまま。reserveを単に75へ戻すと穴が半割の継目付近へ移るので避ける。T戻し糸の有効長は約2.094mm長く調整。Tばね長0°=16、15°=17.047、30°=18.094（自由長14、予伸び2）。Gの初期長は18.094のまま（参照角30°）、P16。
- 曲線化はprototype.pyのspring_cassette。XZカプセルの取付bar、XYのBezier曲線に沿う幅3リブ、YZの円弧で肩と先端を丸めた側板、案内輪上下の丸いR5.2台＋絞ったつなぎ。ねじ位置・輪軸(14,−24)・ばね固定点(18,18,z)を維持。固定ケースの輪周り逃げはR5.4へ。ケース閉じ／輪横挿し／軸下挿しの検査を継続。
- 外面は公称X24.5へ揃え、旧梁の0.5mm張出しを除去。BRep包絡は曲線Booleanで24.508を返すためstyle検査は0.01mm許容。支持部の制御点13箇所の残存と単一ソリッドを確認。実物の支持や強度は未試験。

出力は軽量HTML約0.97MB・10姿勢・48部品（曲線ブラケットボタン／押込み断面あり）、STL34種類47個（比較用横ピン1含む）、3MF3枚、STEP3、一式ZIP。ねじ25本＋ナット5、JB14×3、線材と金属横ピンØ1×5.8はB2同様。0.2ノズル推奨、台0.4可。

release.json checks_pass=True。剛体9姿勢0、組立1499組0、ねじり37姿勢0（0〜30°31点＋開口5/35の0/15/30）、押込み41位置0、意図した拘束23項目通過。0°で−1°へは止まり＋0.5°は自由、30°で戻りは自由・＋1°は止まることも確認。STL閉・単一ソリッド/A1内、STEP3有効、Chrome10姿勢・7範囲・48部品エラー0。ばね占有体積0、最小約0.250mm。曲線形状の取付／フック／輪の支持点も残存確認。実際の印刷・組立・摩擦・ばね力・復帰精度・耐久は未試験。

run_complete.py（CAD出力＋基本/動作/ばね）、check_style.py（支持部）、documents.py（CSV）、make_plates.py、export_lines.py、ブラウザー確認後release.pyで集約とZIP。B3の組立説明はdocsの静的原稿で維持し、documents.pyはCSVだけ生成。ブラウザー補助はルートcad/check_bench_v3.cjs。再開時はまずB3を読む。Pico・サーボへの送信や実際の印刷はしていない。

---

以下はB2までの保存記録です。

# 最新作業：卓上手動版B2（2026-11-04）

[README](bench_manual_v2/README.md)、[組立](bench_manual_v2/docs/組立と手動確認.md)、[軽量HTML](bench_manual_v2/output/卓上手動治具.html)を読む。ユーザー指摘の押込み部の組立／伝達／落下、爪の脱落、半割の噛合わせを精査して改訂。B1と全体V0.12は未変更。

- B2原本はbench_manual_v2/cad。refinements.pyに受け肩、上端ピン、ケース／カムの合わせキー、カムの2段位置決め環、Cレールの着脱端止め。head.pyでレール掛かりを補強しラック背面と上ガイド、環状のつなぎを追加。両端を一体で閉じると爪を入れられないので、各端から各爪を入れてから各2本のM1.4×4で端止めを留める。
- 押込み伝達は二面幅。棒R1.25で平面±0.9、ドラム穴R1.35で平面±1.0。回転を伝えて軸方向に滑る。片側公称0.1mmの隙間で回転遊び約7°があり、120°指令だけで実20mmは保証しない。横ピンが固定カムの螺旋溝で下降を決める。ドラムと棒は接着しない。
- 既存の上端保持はばね任せだったので横向きの上端固定ピンを追加。case/rodともZ32でØ1.2横穴、印刷ピンØ1の軸X−6〜6、頭X−7.2〜−6。頭が屋根に当たったので外側へ逃がした。待機で挿し、P操作前に左へ抜く。全待機の固定ピンは計4本。
- カム上端Z24〜24.4にR3.3の受け肩、ドラム下端24.5、上端29.3と固定ガイド29.5で軸方向の公称隙間下0.1／上0.2。カム自体は旧固定キーと2段環で固定。棒の二面幅噛合いは全20mmで4.8長、全押込み時の棒端はドラム上端より0.7上。
- 爪キャリッジの上掛かり0.1→0.5、下掛かり0.8。隙間下0.15／上0.2／横0.2。ラック背面と上にも各0.2の案内。新しいレールがG案内取付ボスと当たったため、固定側のZ10.3〜11.1／R6.5〜25.5だけ逃がす。主糸の案内通路Z12.5以上は維持。
- 両端固定梁を消すとガイド籠が2ソリッドに分かれたため、Z3.0〜3.8、内R3.4／外R5の低い環状つなぎで一部品を維持。爪足のX±7.2を避ける。底をZ3.0へ揃えて印刷しやすくした。
- ケースキー2個：3×0.9×0.9、位置Y−31.8/Z25.3とY−28.2/Z32.8。カムキー2個：1.6×0.6×1.4、Y+2.15/Z18とY−2.15/Z22.8。キーを入れて半割を閉じる。半割の面は平らに印刷できる。キーの片側だけ仮固定可、反対側やカム溝は接着しない。
- 横フォロワの旧6.3mmだと周囲ハブID3.2との最小幾何隙間が約0.01しかなかったので、Ø1×5.8へ。旧品なら両端を0.25ずつ仕上げる。印刷比較用も短くした。金属丸ピン推奨。

STL34種類47個（比較用横ピン1含む）、3MF3枚、STEP3、軽量HTML約0.95MB・10姿勢・48部品・縦断面表示と二面幅SVG。ねじ25本＋ナット5。M1.4×4小頭が計7（旧3＋端止め4）、その他ねじはB1と同じ。B1からの変更部品CSVも出力。

run_complete.pyで一回のCAD構築からexport→剛体／組立→拘束／押込み経路→ばね検査。report.jsonは9通常姿勢、組立1499組0。function.jsonは19拘束確認＋押込み0.5mm刻み41位置0。STL単一ソリッド・閉メッシュ/A1内、STEP3有効。Chrome10状態・7範囲・48部品JS/WebGLエラー0。実印刷・組立・摩擦・ばね力・ガタ・耐久は未検証。release.jsonが集約、release.pyでZIP作成。原本と出力の一致とねじ配置／数量／3MF一致も検査する。

次のユーザー指示があるまで、全体V0.12へ勝手に反映しない。Picoやサーボへ指令を送ったり、実際に印刷したりはしていない。

---

以下はB1までの保存記録です。

# 最新作業：独立した卓上手動版B1（2026-11-04）

ユーザー依頼：「全体HTMLが重いので、バイアルなし・手動確認の卓上治具だけ独立した完成データを。ねじは購入する。必要サイズ・数、部品リスト、HTMLとCADを渡す。耐久設計は不要、主要構造を大きく変えない。0.4ノズルが厳しければ説明」。対応済み。

最初に[卓上版README](bench_manual_v1/README.md)、[組立](bench_manual_v1/docs/組立と手動確認.md)、[購入品と印刷](bench_manual_v1/docs/購入品と印刷.md)を読む。V0.12は未変更。bench_manual_v1は他フォルダーをimportしない自己完結CadQuery原本。出力一式はoutput/卓上手動治具_B1_一式.zip、HTML約0.83MB、STEP3、STL30種類40個（比較用フォロワピン1個含む）、3MF3枚。ねじ21本＋ナット5個、JB14×3、PE約0.3×2m、PTFE1.6/0.8×100mm、推奨金属Ø1×6.3ピン1本。Picoとサーボは今回不要。

## 手動版で変えた箇所

- 主糸は上向きに直接引く。長いアウターと外部チューブ固定クランプを外した。手引きつまみは8×4×3で3個。最初の14×8ではTの糸がPつまみを貫通したので細くし、24経路検査0を確認。
- 右半割ケースへ円弧の±30°端止めを追加。スロットR13.45の上下範囲Z20.3〜21.8、中心端±30°で隙間を含む物理端約±31°。上側軸受リップにもピン通路を切る。切らないと短い動作ピンがケースに当たる。下側リップは0°固定穴を残す。
- 長い0°固定ピン（shaft Z14.3〜22.3）と短い動作ピン（Z17.2〜22.3）を差替え。丸頭が固定、四角頭が動作。固定ピンを抜いただけでばねを放すと0°には止まらないため、動作ピンを付けて端止めを使う。G/Tを保持しながら交換。
- 新しいガイドは後組みのR半割戻し輪を横から入れる経路に当たる。そのため**戻し輪を先に装着してからケースを閉じる**順番。内部リングを入れた状態のケース閉鎖も検査済み。
- 5mm開口ゲージを追加。非使用時は台の前に置き、最小開口姿勢では爪の間へ入る。動作前に外す。
- ばね初期長はG/T18.09、P16（自由長14）。「予伸び2」は各系統の参照角での値で、0°初期姿勢で全3本が2mm伸びではない。
- 台底面Z0、ヘッド基準Z42、爪Z26〜31、押し足34→14、初期外形60×78×125（つまみ込み）。バイアル位置再現台ではない。

release.jsonのchecks_pass=True。通常8姿勢の剛体0、組立途中809組0、上向き糸24経路0、ばね占有円筒24本の剛体0（最小0.25、新ガイド付近）、STL閉・単一ソリッド/A1内、STEP3有効、Chrome9状態・6表示・43部品エラー0、3MFと数量表一致、ねじ数とCAD配置一致。最小0.25は現物で擦れば固定ガイド外側を仕上げる。実際のスライス・印刷・組立・摩擦・戻り力・耐久は未実施。

歯車m0.5/24歯の歯先幅約0.282、戻し溝の肉厚0.25、ピンØ0.7等があり、耐久性を無視しても0.4では形状再現が不安。ヘッド0.2mmノズル・積層0.06〜0.08推奨、台0.4mm・0.12〜0.16可。0.4最細積層だけでXYの細さは改善しない。主構成は金属横ピン推奨で、印刷比較用STLも同梱。

CAD編集はcad/build.py（手動ガイド/ピン/ゲージ/状態）、head.py（主ヘッド）、prototype.py（組立用半割/戻し/側板/小つまみ）。cad/bench.pyで出力、validate.py・check_springs.pyで検査、documents.py・make_plates.py・export_lines.pyで資料、release.pyで集約とZIP。ブラウザー検査補助はルートcad/check_bench.cjs（実行環境依存のため納品CADの必須ではない）。ユーザーPCへ指令送信、Picoプログラム作成、サーボ動作、実物印刷はしていない。

---

以下は全体装置V0.12までの保存記録です。

# 最新作業：V0.12（2026-11-04）

最初に[V0.12 README](v0_12/README.md)、[組立手順](v0_12/docs/組立手順.md)、[ばねの点検](v0_12/docs/ばねの点検と交換.md)、[3D HTML](v0_12/output/viewer.html)を読む。V0.11は変更せず保存。ユーザーの最新依頼は「ばねを水平にし、高さの差を利用して一枚の共通板へまとめる。ばね寿命と張力監視による保守についても説明」。対応済み。

## V0.12の確定構造

- ばねはJB-14の3本を継続。各ヘッドの局所X18／Y方向へ横置き。高さG14.65、T21.6、P25.1。固定Y18、移動フックはY2−各巻取り量。自由長14、公称予伸び2、最大伸び16.19／6.19／9.54。固定側板はねじり時に回らないが、引抜きではケースごと移動。
- 一枚の共通側板＋後ろの斜め梁。M2×2でケースから外せる。独立ヘッド外形約41×62×66、従来74より8低い。ピッチ52、開口35→5、5高爪、20押込み、7サーボと中空2ドラムの連動は維持。
- 戻し糸は各ドラムR4/R4/R3.6から、中心(14,−24)・溝中心R4の自由回転案内輪へ。輪外径9.2、厚1.2、上下隙間各0.2。棚へ横から輪を入れ、最後にM1.6×16の共通軸を**下から**通す。上からだと斜め梁へ当たるので不可。上面M1.6ナット。頭径≤3.2、高≤1.3、ナット対辺≤3.2、厚≤1.3。実物で回転摩擦を確認。
- ねじり戻しスポークはZ20.6から高さ0.55。逆30°で糸に当たっていたため低くした。薄肉スライスを確認。戻し溝は全形状の合体後に再切削し、スポークで溝を埋め戻さない。
- 上ドラム下面の3本の支持突起は90/210/330°へ。旧0/120/240°配置ではG戻し糸が+30°時に当たった。
- G案内蓋・ねじとの逃げを共通板へ追加。逃げで分離した0.135mm³の角の切れ端は捨て、側板は単一ソリッド。
- 印刷側板は+90°Yで外面をベッド側へ。後梁が0.5張り出すため板下面への薄い支持が必要。輪を通す隙間と糸溝へ支持を埋めない。

## 完了したデータと検査

output/validation/release_summary.jsonのchecks_pass=True。剛体21姿勢0、組立途中519組0、局所戻し糸15経路0、水平ばねの全伸縮を含む占有円筒30本と剛体0（最小1.262mm）、ばね同士公称1mm。外部配線40候補、225ペア0、水平ばねとの最小14.2。STL原点89／印刷71、単一ソリッド・閉メッシュ・A1寸法内。STEP7有効、HTML29状態JS/WebGLエラー0。独立ヘッド＋治具32種類44点、3MF1枚。購入品の形状は一括印刷しない。

編集はv0_12/cad/。prototype.pyが共通板・輪・戻し溝、wires.pyが水平コイルと戻し経路、head.pyが基本2ドラム、print_pack.pyが印刷方向、check_assembly.pyが輪横入れと軸下入れも検査。check_auxiliary.pyは局所糸・水平ばね・外部アウターを同じCAD構築で検査。final_report.pyが集約、write_release_docs.pyがREADMEを生成。採用配線はvalidation/cable_routes.json。同じ系統は5姿勢とも同じ指定長を維持すること。

## 保守についての説明範囲

金属引張ばねで戻す構成は一般的。ただしJB-14のこの運動での寿命回数は未確定。許容たわみ内＝長寿命保証ではない。MG90D指令だけでは張力を読めない。外部フォースゲージ／ロードセルで同じ二点の伸びの力を測り、運転回数・往復差・基準差を記録する案を文書化。センサー・自動点検治具・ファームウェアは未実装。予圧調整は戻し糸の有効長を変える方式。ゼロ調整だけで同じ開口でのばね予圧は変えない。張力だけで疲労を全部検出できず、予圧を増やし続ける延命はしない。交換回数・閾値は繰返し実測後に決める。

実物の印刷・組立・モーターへの指令送信・耐久／速度／トルク／配管の連続変形は未試験。通常ねじりは±30°で一周表示はヘッド間外形の比較。次回はユーザーの確認を受けて進める。承認なく構造を大きく変えたり、PLA強度のための大型化はしない。

---

以下は過去の保存記録です。現在の設計は上のV0.12です。

# 最新作業：V0.11（2026-11-04）

最初に[V0.11 README](v0_11/README.md)、[組立手順](v0_11/docs/組立手順.md)、[配線・購入品](v0_11/docs/配線と購入部品.md)、[3D HTML](v0_11/output/viewer.html)を読む。ユーザーは基本構造を了承し、耐久設計を増やさず、印刷・組立・挙動確認ができる段階まで仕上げるよう依頼した。

最終集約のchecks_pass=True。印刷70種類／原点STL86種類、STEP7、キット31種類41点を3MF1枚、HTML29状態。剛体21姿勢・組立477組0、配線40候補未達0・225ペア0、ばね占有体積も隙間を確認済み。現物試験は未実施。

## 設計の核

同軸中空2ドラム、M1/M2＋共通M3の連動、上部固定7サーボ、独立ヘッド各M2×2、中心間52、開口35→5、パッドZ100〜105、押し足127→107の20mm行程、同じ側への退避、中央2関節と両側支持を維持。戻し輪を含む実運転は±30°。一周表示はヘッド間の外形比較で、追加戻し輪を360°動かす仕様ではない。

## 組立のための重要な修正

- 固定ケースをX方向に左右半割。中央カム固定部の不要な下側1.3mmを除き、上ドラムを横切らずに閉じられる。カムは後側キーで位置決めし、旧止めねじは廃止。
- 押し足は棒と一体でもよい。上ドラムは別体、カムとケースは半割、Ø1×6.3の横ピンは後挿しして中央だけ接着。閉じた輪へ足を無理に通さない。
- 把持ピニオンはm0.5/24歯/幅3の印刷別体。六角座と小頭M1.4×6で留めてからガイド籠へ。市販品の無加工装着は未確定で、穴・幅・留め穴の追加加工が必要。
- ねじり戻し輪も半割。ケース閉鎖後、1.7mm上げて左右から寄せ、下げて各M1.4×5で上ドラムへ留める。閉じた中空リングを中央カムの横から入れようとしない。
- 把持の戻し溝はR4／Z14.65へ移し、下側ピニオンねじが糸を塞がないようにした。旧Z10.65の溝へ戻さない。戻し穴の中央穴との接線でSTLに非多様体辺が出たため、穴径と位置を修正済み。
- 爪ラックと5mmパッドを一体化。固定手段のない突合せ別部品をなくした。
- 実ばねJB-14を各3個、着脱カセットへ。上フックは大頭M1.4×8の頭と印刷ボスの間の空間へ掛ける。下端はPEを金属フックへ直接結び、小アイレット3個を廃止。予圧と摩擦は現物確認。最高部Z58／ヘッド全高約74（従来66から+8）。
- 関節と増速軸は通し六角とし、途中の丸い段差が六角穴を通れない問題を修正。軸端のCクリップを追加。長軸は寝かせて印刷するデータを用意。
- 上板は左右2枚＋継ぎ板。中央ケース足は下から入れるM2ナット座、ホルダーにはねじ頭と底面ナットの逃げ。購入ねじは参考形状で、実ねじ山はタップで作る。

## 配線と試験キット

試作はPE約0.3＋PTFE外径1.6／内径0.8。補強ボーデンと同じ圧縮剛性とは評価していない。主案内はR8の蓋付き溝＋短いPTFEライナー。裸線・アウターの端面固定・ドラム内部のビーズと結びを区別。局所はG黄／T青／P桃／戻し緑。

外部曲線長は旧3本・新把持・新押込み各360、新ねじり400、肘各240。**同じ系統は全5姿勢で同じ長さ**。新ねじりは退避時のケースを避けるため延長。直線立上り・端末挿入・インナー巻付き／結び代は別。ばねの実体積を含む占有円筒にも配線を当てて確認する。

印刷用はoutput/print、購入部品はhardware.csv、ヘッド1個のキットは独立ヘッド印刷キット.zip。最初に嵌合片。3MFは配置モデルでG-codeではない。治具はヘッド内部変位の手動確認用で96mmバイアルの全抜栓軌道の治具ではない。後付けクランプで3本のアウター端を固定して手で引く。動かす前に爪2本・ねじり1本のロックピンを抜く。

## 検証と再開

最終数値はv0_11/output/validation/release_summary.json。21離散姿勢、477組立距離検査、一周外周包含／±30°の上側扇形包絡／共有支持、40静止配線と225ペア、ばね占有体積との距離、STL閉辺とSTEP読み戻し、29状態HTMLを確認。物理試験・工具全体の進入・結び・クリップ弾性・摩擦・実効力・TF秒数・180°転回は未確認。

最終のフック空間は材料除去とアイレット削除だけ。hook_clearance_delta.jsonで追加体積0を確認し、基準の無干渉検査を保持した。元の検査ハッシュは上書きせず保存。baseline_prototype_before_hook.pyは検査用旧原本で、現在のCAD原本ではない。

原本cad/build.py、head.py、mechanism.py、drive.py、prototype.py、retention.py。print_pack.pyとbench_anchor.pyは印刷・治具。run_release.pyが生成と検証、final_report.pyが集約。Python=/private/tmp/tf-cad-venv/bin/python。実機信号は送っていない。V0.10は未変更で保存。次は現物の嵌合・手動ヘッド試験を優先し、実サーボホーン適合と連動制御へ進む。

---

以下は過去記録です。現在の原本は上のV0.11です。

# 最新作業：V0.10（2026-11-04）

まず [V0.10 README](v0_10/README.md)、[3D HTML](v0_10/output/viewer.html)、[接続](v0_10/docs/組立と接続.md)、[配線と検査範囲](v0_10/docs/ケーブルと検証.md) を読む。V0.9は保存済み。現在の原本はv0_10/cad。

## 今回の合意と実装

ユーザーはV0.9の方向を了承し、上板の穴抜きから角ごとの撤去、前側の1入口を後側へ集約、中央の露出巻線の必要性確認、全体の配索整理を希望。追加で上板から吊る2本の細棒を不要なら撤去するよう依頼した。

- 上板をリブ骨組みに変更。前側の角を輪郭ごと除去。中央押し棒ガイド・ドラム軸受環は機能があるため残す。ケース単体体積−21.9%（V0.9比、追加コーム／ねじを除く）。上板前縁+19→+5.8だが、全ヘッド奥行き57は爪等で変わらない。
- 後側3入口はG(+10.25,−18)、T(−13,−18)、P(−7.3,−15)。把持の固定案内を反転して後側へ出した。閉じるトルク方向は維持。固定ケースの最終工程で案内溝を全体から切り、リブで溝が埋まらないようにした。
- 3個のフェルールを押さえるrear_cable_retainerをM1.2×2で固定。入口反力は肩からケースへ。各ドラムに内部肩付き端末座・喉穴・径方向穴と参考圧着エンドを追加。圧着品選定、たるみ時の保持、引張試験は未完。
- 金色の螺旋は戻しばねの参考メッシュで、外側ワイヤ端末ではなかった。通常表示で隠し、任意表示は残す。ばねが不要になった／実装済みと主張しない。1線式の戻り力と端部固定は今後の設計課題。ドラムへ入る実インナー線と固定案内は必要なので残す。
- 上板からの反力吊り棒を撤去。柱Z205へM2×2ずつで留めるcolumn_reaction_bracketに置換。斜め梁→X±54.5/Y−30の受け。自由な縦部分91.8→56.8。受け下面148.2と連結台上面148の0.2隙間は調整待ち。押込み反力を柱へ渡す機能を維持。強度・疲労・ねじ保持は未検証。
- 配線は旧3本黄／新3本青／M5の2本紫。ヘッド側6曲線はすべて360mm、M5各240。直線立上り5.3と端末挿入各約4は別。373.3はヘッドアウター切断長の仮候補で、最終切断指示ではない。インナーはさらに巻取りと端末代が必要。長い可動ループを硬く束ねるクリップは追加していない。

## 最終確認値

V0.10の剛体41姿勢0、メッシュ位置ずれ0。一周包含と共有支持も0。配線40候補の未達0、最小剛体隙間0.776、最小曲げ半径30.018、最大長さ誤差0.148mm。225ペア交差0・最小表面隙間1.321mm。STL56閉辺、STEP8読み戻し有効、HTML28状態でエラー0。M7引抜き姿勢の曲率だけrefine_harness_constraints.pyで最終改善。V0.9の旧結果ではなくV0.10の結果。

## 変更しない設計の核

同軸中空2ドラム、2サーボ連動（M1/M2補正＋共通M3）、上部固定7サーボ、独立ヘッドを各M2×2で着脱、開口35→5、接触パッドZ100〜105、押し足127→107の20mm行程、同じ−Y退避、中央2関節と両側支持を維持。ピッチ52、回転部R25なので全角度で外周余裕2。**運転±30であり360°の実機駆動ではない。** PLA強度のために大型化しない。

## 検査と次回の再開

最終数値はv0_10/output/validation/release_summary.json。代表7＋途中34姿勢は剛体0.025mm³超の離散検査。一周の円形外周・高さ別円環の包含、自機固定部7開口・共有支持25姿勢を検査。配線は8本×5静止候補とM4含む225ペアで、同じ物理アウターの連続変形や摩擦を証明していない。56 STL／8 STEP、28状態HTML。旧検査を新検査の合格として流用しない。

Python=/private/tmp/tf-cad-venv/bin/python。主な変更はhead.py、drive.py、wires.py、routing.py、viewer_template.html。refine_harness_constraints.pyは残った静止候補を長さ・曲率の制約付き最適化で改善する補助。採用候補はoutput/validation/cable_routes.json。再探索前に退避し、変更したら外部剛体距離・ペア距離・HTMLを再検査する。

実機信号は未送出。未完は戻しばね・端末・全軸の抜け止め・実ねじ・フレーム分割締結・現物サーボとホーン・供給ガイドとバイアル押さえ・強度・実効力・速度・180°転回。次はユーザーの形状修正を優先し、その後に独立ヘッド1個の現物評価。

---

以下は過去記録です。現在の構成は上のV0.10です。

# 最新作業：V0.9（2026-11-04）

まず [V0.9 README](v0_9/README.md)、[3D HTML](v0_9/output/viewer.html)、[一周包絡検査](v0_9/output/validation/rotation_envelope.json) を読む。ユーザーはV0.8の方向を了承し、バイアル間隔を全ねじり角で干渉しない程度へ広げ、不要形状を整理するよう依頼した。構成を別方式へ変えない。V0.8は保存した。

## 今回の設計

- ピッチ34→52。回る爪・ガイド・2ドラムの外周を半径25の内側へ包含。`52−25−25＝2mm`の外周余裕。円形包絡なのでねじり角によらず、左右の角度が違っても外周同士が届かない。実頂点の最大半径は約24.91。
- 「全角度」の間隔設計は一周の外形を基準にした。**実機の運転範囲は既存の±30°を維持。360°サーボ行程やワイヤ連続旋回の設計へ変更したわけではない。** HTMLの一周9姿勢は`envelope_only`、実機指令ではない。そこで上部サーボは中立表示。
- ガイドレール46→44.4。開き端爪・ストッパーを残して端の余分な張り出しを除去。開口35→5、パッド高さ5は維持。
- 支持オフセットを左右15ずつ拡張。根元主アームX±73、先端主アームX±61、頭部主支持X±57、固定押込み受けX±54.5、柱X±91。対応する共通軸と連結台も延長。中心線のYZ軌道・関節構成は維持。
- 支持位置の実パラメータは`support_offset=15`。`post_x=91`、`root_capstan_x=-109`は対応する基準値。ピッチ・包絡を変えたときはこれらと配線も再検査する。
- 上板へ丸角窓4個、主アーム2種類へ長穴。ケース材料体積−8.18%、主アーム−18.70%／−21.49%。幅拡張で軸・連結台が増えるため、全体が同割合で軽くなったと説明しない。肉抜きの強度・疲労は未検証。
- 同軸中空2ドラム、M1/M2とM3の連動制御、上部7サーボ、バイアルごとの独立ケースをM2ねじ2本で接続、爪100〜105、押し足127→107の20mm行程、同じ−Yへの退避を維持。

## 検証と表示

`check_rotation_envelope.py`：円形外周へのBRep包含、9層の円環包絡を使った自機固定部の7開口検査、共通支持部との25姿勢検査。端点の爪の平行移動の凸性で外周上限が中間開口にも適用される。下ドラム自体は半径11内なので相対角によらずこの上限に入る。

`validate.py`は代表7姿勢、`validate_motion.py`は途中・範囲34姿勢の全剛体とガラスの離散検査。0.025mm³超を判定。スポンジ・ワイヤ・参考ばねは対象外。連続掃引や実機動作の証明と混同しない。

HTMLは通常・説明19＋一周外形9の計28姿勢。最接近角約63°をボタンから見られる。金色の輪は回る部品の半径25包絡であり、固定ケース全体の外形ではない。STL51種類、STEP8ファイル。`assembly_27.step`は最接近角の外形確認、運転状態ではない。

配線はV0.8の曲線を初期値にし、新しい固定点・支持部で再探索。個々の候補と剛体の隙間に加え、ボーデン8本＋通常M4ワイヤ2本の225ペアを静止5姿勢で検査する。曲線の制御点は左右レーンへ分け、端末直近を含む他ケーブルの密な点群で交差を避ける。最終数値はV0.9/output/validation/release_summary.jsonを参照。連続した同一アウターの変形・摩擦・たるみ・遅れは未実証。

## 納品時の状態

通常代表7＋途中34姿勢の剛体重なり0、メッシュ位置ずれ0。一周の包絡包含・自己固定部7開口・共有支持25姿勢の検査も0。STL51種類、STEP8ファイルの読み戻し有効。

配線は40候補を新形状で再検査。左ねじりのアウター曲線長を320→360へ延長し、全5姿勢で同じ長さを維持。旧側の把持・ねじり・押込みは曲線長各360。右ねじりは320を維持。モデルとの静止隙間最小約1.00、曲げ半径最小30.33、長さ誤差最大0.15。ボーデン8本＋M4通常2本の225ペアで交差0、表面隙間最小約1.61。直線立上り・端末差込みは別途のため、その曲線長をそのまま切断長にしない。

`extend_left_twist_route.py`が長さ延長、`repair_crossings.py`が密なケーブル点群を使った再配索。片方の線が他方の端末直近を横切る場合、端末側の線だけを変えても解消しないため、横切る側を調整した。連続変形・実機摩擦は未検証。

## ファイルと再開

原本は`v0_9/cad`。基本構成はV0.8と同じ。新規`check_rotation_envelope.py`が全角度余裕、`repair_crossings.py`と`cable_math.py`が静止配線の交差調整。`release_report.py`が検査集約。Pythonは`/private/tmp/tf-cad-venv/bin/python`。再生成はREADMEのコマンドを使用。

実機へのシリアル・PWM・ファームウェア書込みはしていない。戻しばね・ケーブル端末・全軸の抜け止め・実ねじ山・実サーボ／ホーン適合・外部供給ガイドとバイアルの押さえ・強度・実効力とTF秒数・180°のバイアル転回機構は未完成／未検証。今後はユーザーの形状修正を優先し、次いで独立ヘッド1個の現物試験へ進む。PLA強度を理由に大型化しない。

---

以下は過去の記録です。現在の構成と再開位置は上のV0.9です。

# 最新作業：V0.8（2026-11-03）

**設計はユーザーの明示依頼で再開済み。下に残る過去の「停止」「未作成」は履歴です。**

まず [V0.8 README](v0_8/README.md)、[現状HTML](v0_8/output/viewer.html)、[組立接続](v0_8/docs/組立と接続.md)、[ケーブルと検証](v0_8/docs/ケーブルと検証.md) を読む。V0.7A・V0.6は上書きしていない。

## 維持する合意と最新の変更

- 実際にワイヤを巻く**同軸中空2ドラム**。M1/M2は下ドラム、M3共通は上ドラム。**2サーボの連動制御を維持**。1サーボの力しきい値／クラッチ切替へ勝手に変えない。ヘッドに別軸のねじり伝達輪・かさ歯車を戻さない。
- 下ドラム内側の小型ピニオン／対向ラックは平行把持に使用。開口35→5、接触パッド5。外径30の柔らかい栓を想定。バイアルØ23×96、ピッチ34。
- 上部固定7サーボ（M1/M2独立把持、M3共通ねじり、M4/M5共通2関節、M6/M7独立押込み）。MG90D実物ホーン・スプライン・可動角・トルクは未適合。
- 最新依頼で中央歯車案を判断してよいと許可された。左右に歯車箱を複製したV0.7Aから、**中央1歯車箱＋共通軸＋左右の支持アーム**へ変更。サーボを二重に増やしたのではない。「2軸」は左右への共通出力・両側支持の目的で解釈し、両軸サーボ購入はしていない。
- 根元Y−70/Z116、リンク40＋50、初期肘Y−41.43。以前の根元Y−90から前進。2段の受動平行リンクを追加し、頭部は垂直のまま2DOFで移動。両栓が同じ−Yへ退避する。
- 根元の受動軸を通し軸にすると途中で主アームと交差したため左右の短軸へ変更。肘主軸も±61で終わらせた。片側だけの支持へ戻さない。
- 蓋1個分のグリップ／ねじり／押込みは完全な独立ケース。共通連結台へM2×2で着脱。上ドラムとガイド籠はM1.2×2で外せる。螺旋カムは半割でフォロワを挟む。CAD上で閉じた筒へ組立不能な一体ピンを入れる説明にしない。
- 初期爪Z100〜105。閉栓上端107、突出約11。ヘッド初期116。再装着ヘッド135、保持栓上端126／下面96。爪を35へ開く→押し足127から107へ20下降（1接近＋19押込み）→棒127へ戻す→ヘッド116へ戻す。栓は107に残る。
- 押込み反力を逃がす固定受けが上部板から下がる。X±39.5、Y−30、下面Z148.2。連結台の上面Z148へ当てる。高い位置から直接進入せず、Y−8/Z135へ戻してから水平にY0へ。受けの細い金属板の強度は未計算。
- ホルダーは中央側半周だけ。旧＋X／新−Xを残し、旧−X／新＋Xの供給側を空ける。
- ケーブルはインナー0.3556の7×7ステンレス候補、補強アウターOD2.5/ID0.8は未調達の設計枠。2.5在庫品があると断言しない。3.5用への交換フェルールを想定。ヘッドの取出しは上向き。関節軸貫通は採用せず外部ループ。
- 把持・ねじり・押込みは各1線＋戻しばね、引抜き2関節は拮抗2線。合計インナー10走／アウター8走。ばねは参考線で、定数・予圧・端部固定は未設計。1線式の実物成立を確認したと主張しない。

## この納品時の検査結果

V0.8/output/validation/release_summary.jsonが集約。代表7＋途中34姿勢の全剛体重なり0（0.025mm³超）。非対称把持6組合せもヘッド相互0、最小約1.88mm。8本×5静止姿勢の外部配線候補は曲げ半径最小30.96、長さ誤差最大0.00012、モデルとの隙間最小1.86、アウター同士1.74mm。動的な同一ケーブルの連続追従は未証明。51種類のSTLは閉じた辺接続、7 STEPは全読み戻し有効。HTML19状態のChrome検査でJS/WebGLエラー0。

カム止めねじ穴の上端がケース上面へ接して非多様体辺ができたため、中心Z19.6→19.4へ0.2下げて修正。STLとSTEPを再出力して再検査済み。接線状態へ戻さない。全長の旧把持アウターは、退避時の余裕のため一定長360mmの曲線へ延長。他の長さ・差込み・直線立上りはケーブル説明を参照。

## ファイルと作業手順

`v0_8/cad/build.py`（全体・19状態・出力）、`head.py`（独立ヘッド）、`mechanism.py`（中央2関節・平行リンク・ホルダー）、`drive.py`（上部配置）、`wires.py`（局所配線と参考ばね）、`routing.py`（全長候補探索）、`repair_routes.py`・`repair_old_grip.py`（候補改善）、`publish_viewer.py`（配線だけ再収録）、`validate.py`（代表7姿勢）、`validate_motion.py`（途中30＋範囲4）、`validate_cables.py`（全長折線とBRepの距離）、`control_model.py`（連動と指令範囲）、`check_deliverables.py`（STL・STEP・金属重量の概算）。

Pythonは `/private/tmp/tf-cad-venv/bin/python`。再生成・検証コマンドはREADMEに記載。実機へのPWM・シリアル・ファームウェア書込みはしていない。既存の別版ファームウェアを今回の7軸へそのまま使用しない。

上部板260mmはA1一体造形範囲超え。CADは金属機構の検討用で、全フレームの分割締結、全軸抜け止め、実ねじ山・購入部品SKUは未完成。製作可能と断言しない。PLA強度を理由に外形を大きくすることはユーザーが不要と明言している。

次は、ユーザーの形状修正を優先。次いで独立ヘッド1個で栓・ばね・線材・端末を実測し、その後左右共通軸とアームへ拡張。配索の姿勢別候補があっても同一アウターの連続変形・擦れ・ヒステリシスまで証明していない。検査結果はV0.8内の最新版のみ参照し、過去版を流用しない。

---

以下は以前の経緯です。

# 最新：V0.7A 中空2ドラム・左右2関節複製（2026-11-03）

[現状HTML](v0_7A/output/viewer.html) ／ [V0.7A README](v0_7A/README.md)。ユーザーが設計再開を明示し「30分程度で一旦CAD」と依頼。直前の中断記録は過去のもの。

最新の確認：**2サーボの連動制御は維持し、別体のねじり伝達部だけ外す。** 1サーボによるストッパー切替・力しきい値連動にはしない。M1/M2把持ドラム、M3共通上側ねじりドラム。下側／上側とも本当に巻取り溝のある中空ドラム。ヘッドの別軸巻取り輪とかさ歯車はなくした。爪開閉の中央小型ピニオン／ラックは残し、これを説明に明記する。

両方の柱側に根元・先端それぞれの入力輪、歯車、ケースを設置。反対側は軸受だけではない。M4/M5のモーターは各1個で、上部共通軸と複数巻取り輪で分配。共通軸は左右を連結。先端軸は263.4mmになるため左右分割と中間六角スリーブを追加。

接触パッドは高さ5mm（Z98〜103）。細い支持部は別部品。最高剛体部Z157、前版185から28mm低減。ケーブルの外部延長はこの寸法に含まない。押込み10mm／60度は維持。14姿勢HTMLと4姿勢STEP。最新版検査はv0_7A/output/validationを参照。V0.6の検査・配線を流用しない。

ワイヤの曲線案内は参考線で、案内部品・曲げ半径・全長配索は未確定。締結、軸方向固定、ばね予圧、ねじり／押込みの無通電ロック、MG90D適合・トルク・実速度も未検証。今回は概略CADの確認が目的で、詳細を先行させすぎない。

---

# 最新の合意：ここで区切る／次回は案を分けて比較（2026-11-03）

ユーザー：「一旦これでいいんだけど、中空ドラム2こでやるんじゃなかった？その話で進んでるもんだと思ってたけど。あとでバージョン分けして検討しよう」

**設計作業はいったん停止。新たなCAD案の生成・詳細化を自動継続しない。**

本来の合意は、中空ドラム2個を同軸に重ねて把持とねじりを行い、相対角はサーボ連動制御で保つ案。V0.6は縦ワイヤ入力のため別軸巻取り輪とかさ歯車、中央ピニオン／ラックを追加した派生案であり、合意した中空2ドラム案をそのまま具体化したものではない。助手が変更を広げすぎたことを認めた。

次回は **A：本来の中空2ドラム案** と **B：V0.6の別軸入力・歯車案** を別バージョンで比較する。Aはまだ合意どおりのCADを作成できていない。V0.6をAの完成形として扱わない。V0.6および既存リンクはそのまま保存し、今は新バージョンを作らない。共通軸・両側支持・柱位置など、ユーザーが了承した変更と、未了承のヘッド伝達方式を区別する。

---

# 最新作業：V0.6（2026-11-03）

次回は [V0.6 README](v0_6/README.md)、[3D HTML](v0_6/output/viewer.html) を最初に読む。ユーザーはV0.5を了承し「この方向で進めて、1時間以内目指して」と依頼。今回の作業はV0.6へ保存し、V0.5は上書きしない。

## 今回進めたこと

- 両関節の共通軸・左右支持を維持。六角駆動座とケース両側の軸支持を具体化。
- 先端関節の小型駆動箱は右の柱の外側へ移動。退避中の柱干渉を解消。支点・軌道は維持。
- 上下2ドラム：下側Ø16へ縮小、中央ピニオン＋対向ラックで35→5。Cガイドと開き端ストッパー。
- 中央押込み：Ø6の細径螺旋カム、Ø2.5二面幅軸、Ø4.5押し足、60°／10mm下降。小径足の栓への影響は未実測。
- ヘッド上端の共通プレートへ6個のアウター端を集約。入力輪まで裸のインナーが垂直に走る。入力軸は両側支持。
- 上部サーボ台にフランジ穴と本体逃げ、下向きアウター座と配線穴。
- 無通電初期固定：爪4・ねじり2・押込み2・関節2の計10本の手動抜差しピン。実穴を設けた。強度・保持・抜去検知は未実証。
- 独立把持、逆ねじり、5mm閉口のままねじりを含む14姿勢。制御連動式は60組合せ確認。実機書込みなし。

## 現在の検査範囲

`output/validation/rigid_audit_current.json`：14姿勢で有効な全剛体ペア（歯車・ピン含む）とガラスを検査し、0.025mm³超の重なり0件。ワイヤ・ばね・スポンジ変形は除外。HTMLメッシュの位置ずれ検出0。検査後、根元ロック金具の切り残し0.083mm³だけ除去。新規材料0の部分集合なので重なりゼロは維持される。証明はroot_lock_cleanup.json。

全長配線は500mm（押込みだけ600mm）の露出アウター長で4姿勢の数値候補。端部挿入4mm×2で切断候補508／608mm。曲率・長さの条件とは別に、近接が残る。最終状況はviewer_payload.jsonを参照。全長はHTMLのチェックで任意表示し、動的成立を断言しない。

## 次の優先事項

1. ユーザーの形状修正を優先。概略レベルでよいという意向を保ち、外観やネジ細部を先行させない。
2. 近接するケーブル経路を確定し、途中姿勢・擦れ・実曲げ半径・摩擦と動作遅れを確認。
3. 近似かさ歯車の正式歯面／加工公差と連続歯当たり、軸方向位置、締結とばね予圧を決める。
4. 実物MG90D、栓の抜栓力／押込み力／傷み、トルクとTF時間を測る。金属想定で、PLA強度を理由に大型化しない。
5. V0.4ファームウェアは使わない。V0.6の連動式はcontrol_model.pyで検査した段階。ハードへは出力していない。

原本はv0_6/cad。build.py（基本形状と姿勢）、head.py（ヘッド）、joints.py（両関節）、drive.py（上部駆動）、routing.py（配線候補）、publish_viewer.py（HTML再パック）、validate.py（全剛体検査）。Pythonは/private/tmp/tf-cad-venv/bin/python。実行方法はREADME。

---

# 最新作業：V0.5 構成確認CAD（2026-11-03）

次回は **[V0.5 README](v0_5/README.md)** と [最新HTML](v0_5/output/viewer.html) を最初に読む。V0.4以前は過去版。ユーザーが「CADを止めて」とした後の議論を経て、今回「以上を踏まえてCADを作成、30分以内を目処に進捗」と明示的に再開を指示。

今回：両関節の左右支持＋共通軸。退避支点は動かさず柱をY−90まで前進。根元歯車を上下配置し通常ワイヤを垂直化。全サーボ横軸、前2＋中央3＋後2。薄い上下2ドラム：上は全体ねじり、下は中央ピニオン＋対向ラック把持（35→5）。把持ドラム絶対角＝ねじり角＋相対角でサーボ連動。押込みは60°回転・10mm下降の固定螺旋カム＋摺動六角軸。最終材は金属、PLA強度を理由に大型化しない。

**今回の詳細度は構成・姿勢確認まででよい、細かな歯形・ネジ等は不要というユーザー合意。** かさ歯車はピッチ包絡、初期固定具は配置形状、ヘッド入力軸受・締結や長いアウター配線は未設計。旧版の全剛体干渉ゼロやファームウェアを流用しない。V0.5のSTL/STEPはconcept名で製作未承認。次回も先にHTMLで確認し、細部へ進みすぎない。

原本：v0_5/cad/build.py + parameters.json。11姿勢HTML、4姿勢STEP、各部STL、部品一覧、検査記録を保存。検査結果の最終数値は v0_5/output/validation/concept_checks.json と viewer_report.json を参照。V0.4は上書きせず保持。

---

# 最新作業：V0.4（2026-11-03）

V0.3の中断後、ユーザーの「続きを」により再開済み。**次回は [V0.4の進捗と次の作業](v0_4/進捗と次の作業.md) を最初に読むこと。** 以下のV0.3記録より最新指示を優先する。

最新HTML：[V0.4 11姿勢](v0_4/output/progress_now.html)。最大開口35mm、短リンク把持、低い共通ラックねじり、約10mm押込み、金属製を前提。大径伝達円盤を小径ドラム＋根元2段／先端1段歯車へ変更。全サーボの入力ドラムは同一の最大径24mm。ボーデン7経路。

最新原本はv0_4/cad。簡易6姿勢で剛体干渉0件。最新関節の全面途中角度検査、全長配索、STL/STEP/BOMの最終出力は未完。古い出力はpre_joint_revision名へ分離。ユーザーの最新依頼は「今の進捗HTMLを見たい」で、まず現状形状を公開した。

---

# 以下は過去のV0.3中断記録

# 中断時の引継ぎ — 2026-11-03 07:44 JST

ユーザーの依頼で、完成作業をいったん中断。次に「続けて」と言われたら、このファイルと `v0_3/CHECKPOINT.md` を読み、V0.3を継続する。V0.1/V0.2から作り直さない。今回の中断時点で製作承認・実機動作保証はしていない。

## 現在の要求（新しい指示を優先）

- 動力は上側固定。5サーボを一列にせず、把持2個と共通3個に分ける。
- ねじりは、ユーザー確認済みの「2爪を一緒にバイアル中心まわりに回す」方式。
- 栓最大径30mm。開口55→5mmを保ち、外周の大きな保持リングをなくしてバイアルを近づける。
- 爪は並ぶ2本の間を避け、前後方向に配置。新旧を同じ−Y側へ引き抜き・退避。
- 中央から棒を下ろして再装着を押し込む。追加1〜2サーボ可。現案は独立2個追加、合計7個。
- 現実のワイヤー／ボーデンの固定端・巻取り・取り回しを具体化。
- 底ホルダーは外側180°をなくし、旧側−X、新側＋Xから供給。
- 最後の依頼：ここで区切る。問題が残っていても現状をHTML表示し、再開可能な記録を残す。

## 現案

編集原本は `v0_3/cad/build.py` と `parameters.json`。CadQuery、mm/degree。

- バイアルØ23×96、中心間34mm。ヘッド幅26mm×前後長110mm。
- 外周リング・ラック・円板カムを撤去。上側中空軸で細長いヘッドを支持。
- 前後2爪をCガイドで平行移動。ボーデン対で片爪を駆動し、2本のUワイヤー／端アイドラで反対爪を同期。面間55〜5mm。
- ヘッドごと±30°回転、M3共通。並行回転する26mm幅のヘッドの法線方向間隔は34cos30°=29.44mm（名目隙間3.44mm）。
- 共通2関節、リンク45+45。引抜き(a,b)=(0,90)、退避=(45,90)。全ヘッド角135°。バイアルを180°転回する別機構そのものは未設計。
- 中央Ø12足／Ø5.5棒、クランク22・リンク44。150→30°で38.105mm下降。栓との接触後の実押込みは仮の突出16mmに対し8mm。足の最終高さ104mm。
- M1/M2把持、M3ねじり共通、M4根元共通、M5先端共通、M6/M7各側押込み。固定上部2+2+3、M4のみ横向き。
- モーター台高さ324mm（旧270では途中の押込み塔と干渉したため変更）。支柱162mm×2分割。
- 駆動半径：入力12,12,12,16,14,10.25,10.25。出力M3=13、M4=55、M5=25、M6/M7=13。正逆ワイヤーの溝を分離。
- 半円ホルダーに印刷たわみ葉を追加。ガラスへの接触は意図した予圧であり、剛体干渉ゼロと扱わない。

## 検証の現状と残作業

1. **最新の簡易干渉検査には2件残る。** 段階0の各側 `shaft_shim_0.8_1` と `twist_lock` がそれぞれ約1.2324mm³重なる。上側半割シムにØ2.4程度の位置決めピン逃げを切るのが次の小修正候補。中断依頼後は形状修正しない。
2. 最新の留めピン、支持台固定、軸方向スペーサー、半割シムまで含む形状は `check_geometry.py` で6姿勢を確認。他はこの時点で0.04mm³超の重なりなし。ただし同一爪の割り栓の0.1mm圧入代は除外。この簡易検査は割り栓除外が広いため、正式検査は所有爪だけを除外する `validate.py` を使う。
3. `output/validation/mechanism_report.json` の28姿勢ゼロ干渉は**留めピン／シムを追加する前の版**。最新原本の証明に流用しない。最新原本の全面再検証と全STEP/STL再出力が必要。
4. `routing.py` は14本のボーデンについて、固定端方向、外側面間650mm一定長、設計曲げ半径50mmの4姿勢候補を算出。最新の固定金具追加前の配索なので、新しい金具との近接と途中姿勢は再検査が必要。実際のケーブルの弾性・摩擦・圧縮・ヒステリシス・動的干渉は未解析。
5. 最小プーリー溝底Ø20、ワイヤー0.5mmでD/d=40。金属補強アウターOD3.5/ID1.5、POMライナの調達候補あり。無補強PTFEだけで代用しない。端末ニップルの実製作・耐力と張力調整は未実証。
6. MG90Dの現物外形・ホーン・パルス・実角・トルク未照合。PLA摩擦、強度、たわみ、ケーブル重量を含むトルク余裕、抜栓力、押込み力、ホルダー保持力を実測する。完成した動作装置とは区別する。
7. `firmware/tf_v03/tf_v03.ino` はUNO＋Servoのコンパイル済み。7系統、起動時detach、1段ずつNEXT。`CALIBRATION_VERIFIED=false`で駆動を封止。アップロードも機械操作も実施していない。
8. 組立説明、ケーブル切断表・端末表、最新BOM、印刷方向、STLの全数検査、全STEP再読込み、完成用ZIPは未完。中断HTMLとその引継ぎ一式を優先した。

## 再開の順序

1. `v0_3/CHECKPOINT.md` と最新 `cad/build.py`、`cad/routing.py` を読む。
2. 段階0シムのピン逃げ2件を直し、短い `check_geometry.py` を通す。
3. 留めピンの挿入方向、抜け止め楔へのアクセス、支持台の固定・軸方向位置決めを確認する。楔はピンの長穴に合わせ、長手を穴の貫通方向に90°回して挿す。実印刷の嵌合は別途。
4. `validate.py` の28姿勢、実ガラス、独立開閉、押込み限界、退避時の仮TF回転空間を検査。
5. 全CAD生成→配索生成→配索の近接検査／切断表→プレビュー生成→STL/STEP/ブラウザー検査。
6. 実測を要する箇所を明記し、組立説明・部品表・配線／校正説明を完成させる。

## 実行環境

- 作業場所：`/Users/hatakeyamahironori/Documents/ChatGPT/自動トランスファー機-arduino`
- Python：`/private/tmp/tf-cad-venv/bin/python`（CadQuery 2.8.0 / numpy / scipy / Pillow）。なければ `cad/requirements.txt` からvenv再作成。
- CAD生成：`python v0_3/cad/build.py`。全状態STEPは時間がかかる。
- 検査：`python v0_3/cad/check_geometry.py`、`python v0_3/cad/validate.py`、`python v0_3/cad/check_exports.py`。
- 配索：`python v0_3/cad/routing.py`、その後 `package_cables.py`、`make_preview.py`。
- ビューア検査：Node `cad/check_viewer.cjs v0_3`（Chrome headless、権限の自動審査が必要な場合あり）。
- Arduino CLI：`/Applications/Arduino IDE.app/Contents/Resources/app/lib/backend/resources/arduino-cli`。UNOビルドは `/private/tmp/tf-v03-build`。
- 既存V0.1/V0.2と資料は保持。参照PDFは `reference/` と元のDesktop資料。PDF内の記述よりユーザーの最新変更を優先。

この中断後、設計を自動継続しない。ユーザーの「続けて」で上記から再開する。

## 調達候補と設計の前提

- 0.5mm A4 7x7ワイヤー：Hamburger Tauwerk、候補1077006。メーカー掲載の0.5mm破断荷重は12kg表記。破断値を機構の許容使用荷重にしない。
  https://www.hamburgertauwerk.de/edelstahl-drahtseil-7x7-flexibel-0-5-12mm-oe/1077000
- 金属補強・POMライナ・内径1.5/外径3.5mm：ARC Reuter / Bowdenzug24、品番101432。掲載対象は主に1.0/1.25mmインナーであり、0.5mm使用時の遊び・摩擦・端末適合は実験が必要。
  https://www.bowdenzug24.com/produkt-kategorie/drahtseile-bowdenzughuellen-federstahldraehte/bowdenzughuellen-meterware/
- プーリー径の設計目安：Savaの7x7推奨溝底径はワイヤー径の40倍。寿命の一般目安で、この印刷部品の耐久保証ではない。
  https://www.savacable.com/sava-expertise/pulleys-design-information
- 設計アウター曲げ半径50mmは採用仮定。選定製品の公式最小曲げ半径として確認した値ではない。
- Uワイヤーは4本、端ニップル中心間113.2013mmが設計値。実長・ニップルØ2.4の製作公差と摺動ガタが把持同期に影響する。
- インナーを押して棒を押し出す構成ではない。対向する引張りワイヤーでクランクを正逆回転させる。
- `parameters.json` の push_stroke / push_max / push_park_tip_local_z はbuild.py起動時にクランク寸法から再計算される。直接値を書き換えても優先されない。

中断HTMLの配索は、固定金具追加前の同じ端点を持つ曲線を重ねている。表示したことを最新金具との無干渉確認と取り違えない。

追記：34mm間隔は2ヘッドが同位相で旋回する前提。独立ボーデン枝の伸び・ガタで位相がずれた場合の接触余裕は未検証。対称姿勢の3.44mmという名目余裕だけで実機の同期誤差を許容したとしない。
